nanjinhan/chamgap/docs/design/wireframe/png/09.png

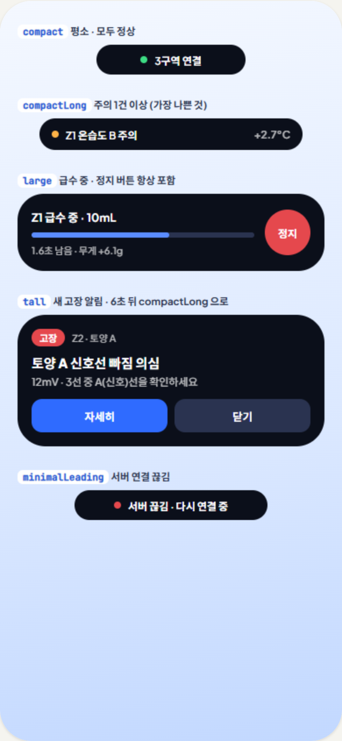
docs/design/wireframe/png/09.png
