nanjinhan/chamgap/docs/design/wireframe/png/08.png

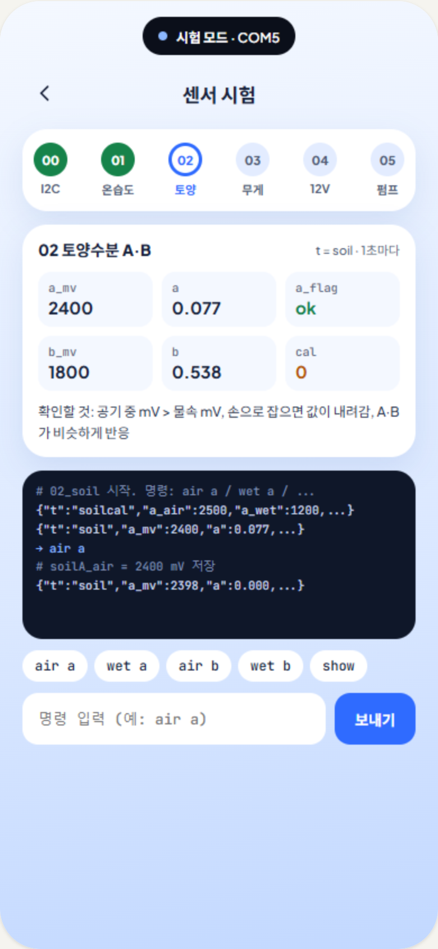
docs/design/wireframe/png/08.png
