nanjinhan/chamgap/docs/design/README.md

팀 디자인 시안은 `reference.png`, 와이어프레임 캡처는 `wireframe/` 폴더에 넣어 주세요. 웹앱을 만들 때 참고합니다.
