nanjinhan/chamgap/docs/01_requirements.md

# 참값(CHAMGAP) 센서 진단 시스템 — 요구사항지시서

| 항목 | 내용 |
|---|---|
| 문서 버전 | **v2.0 (2026-10-23)** — v1.0은 `docs/archive/01_requirements_v1.0.md` |
| 대상 | ESP32 펌웨어, Supabase(클라우드 DB), 웹앱, (선택) 진단 서버 |
| 기준 설계 | 3구역 시험장 제작 설계도 v0.8.1 (배선·핀 번호) |
| 이 문서의 역할 | 프로그램들이 서로 주고받는 **약속**의 기준. 코드와 이 문서가 다르면 이 문서를 먼저 고친 뒤 코드를 고친다 |

요구사항 번호 규칙: `SYS` 전체, `FW` ESP32 펌웨어, `COM` 통신 규약, `CLD` Supabase, `SRV` 진단 서버, `DX` 진단, `SAFE` 안전, `UI` 웹앱, `NFR` 비기능. 각 항목의 **필수/권장/선택**을 지킨다.

## 변경 이력

| 버전 | 바뀐 것 |
|---|---|
| v1.0 | ESP32 ─USB·로컬 MQTT─▶ 노트북 브리지 서버 ─▶ 웹앱. 같은 WiFi 안에서만, 인터넷 공개·로그인 제외 |
| **v2.0** | **ESP32 ─WiFi─▶ Supabase(무료) ◀─▶ 웹앱(Vercel)**. 인터넷 어디서나 접속, 로그인 없음. 급수 안전 검사를 ESP32로 옮김. 저장은 Supabase. 진단은 **선택 기능**(노트북 진단 서버가 켜져 있을 때). 웹 시험 모드 제외. 메시지 키·명령 문법은 v1.0과 같음 |

---

## 1. 목적과 범위

### 1.1 목적
1. **먼저**: 구역 3개(Z1·Z2·Z3)의 진짜 센서 값이 인터넷 어디서나 웹앱에 실시간으로 보이고, 웹앱에서 누른 명령(급수·정지·보정)을 ESP32가 실행해 결과가 웹에 돌아온다.
2. **다음(선택)**: 값을 보여 주는 데서 끝나지 않고, **"지금 이 값을 믿어도 되는지, 안 된다면 무엇이 문제이고 무엇을 확인해야 하는지"**를 알려 준다 (6장 진단).

### 1.2 범위
| 포함 | 선택 | 제외 |
|---|---|---|
| 센서 값 수집·표시·기록 (Supabase) | 센서 이상 진단과 확인 방법 안내 (진단 서버) | 자동 급수 스케줄 |
| 수동 급수(양 지정)와 즉시 정지 | 센서 시험 스케치 00~05 | 로그인 |
| 보정 작업 안내 (영점, 무게, 토양, 유량) | | 휴대폰 설치형 앱 |
| 인터넷 어디서나 접속 (웹앱: Vercel) | | 식물 생육 판단 |
| 하드웨어 없이 개발·시연하는 가짜 ESP32 | | 웹의 시험 모드 화면 (시험 스케치는 아두이노 IDE 시리얼 모니터로 본다) |

### 1.3 구역 하나의 구성 (설계도 기준, v1.0과 같음)
| 부품 | 수량 | ESP32 핀 | 비고 |
|---|---|---|---|
| SHT31 온습도 A (대상) | 1 | I2C SDA 21, SCL 22, 주소 0x44 | |
| SHT31 온습도 B (비교) | 1 | 같은 버스, 주소 0x45 | ADR→VIN |
| SEN0193 토양수분 A (대상) | 1 | GPIO32 (ADC1) | |
| SEN0193 토양수분 B (비교) | 1 | GPIO33 (ADC1) | |
| 로드셀 10kg + HX711 | 1 | DT 26, SCK 27 | 화분 전체 무게 |
| 연동 펌프 + DFR0457 | 1 | GPIO25 (+10kΩ 풀다운) | 12V |
| 12V 감지 분압 47k/10k | 1 | GPIO34 | 비상정지·퓨즈 감지 |
| 누수 감지 (선택) | 0~1 | GPIO35 (+풀업) | |

ADC2 핀은 WiFi와 함께 쓸 수 없으므로 아날로그 입력은 ADC1(GPIO32~39)만 쓴다 (위 배선이 이미 그렇다).

---

## 2. 시스템 구성

```
 [ESP32 Z1] ─┐                         ┌──────────── Supabase (무료) ────────────┐
 [ESP32 Z2] ─┼──WiFi · HTTPS/WSS──────▶│ readings · events · nodes · commands    │
 [ESP32 Z3] ─┘  값·사건 올림            │ (선택) diagnostics                       │
                명령 받아 실행 ◀────────│ Postgres + Realtime                      │
       │                               └──────────────▲──────────────────────────┘
       └─ USB 시리얼 (디버그용, 선택)                    │ 실시간 구독 · 명령 넣기
                                                       │
                                  [웹앱 (React, Vercel)] ◀── 폰·노트북 어디서나
                                                       │
                     (선택) [진단 서버 (Python, 노트북)] ── 값을 읽어 진단을 기록
```

| ID | 요구사항 | 구분 |
|---|---|---|
| SYS-01 | ESP32와 웹앱은 **Supabase 표를 통해서만** 주고받는다. 서로 직접 연결하지 않는다 | 필수 |
| SYS-02 | 펌프를 켜도 되는지의 **최종 판단은 ESP32**가 한다. 급수 안전 검사(7장 SAFE-03)는 ESP32가 하고, 웹은 요청과 사전 안내만 한다 | 필수 |
| SYS-03 | 메시지 내용(키 이름·명령 문법)은 v1.0 4장과 같다. Supabase 표의 열 이름은 메시지 키 이름과 같다. ESP32는 USB 시리얼에도 같은 줄을 계속 출력한다 | 필수 |
| SYS-04 | 하드웨어 없이 개발할 수 있도록 **가짜 ESP32**(기존 서버의 mock 재사용)가 실제 펌웨어와 똑같이 Supabase에 쓰고 명령에 응답한다. 고장 상황을 골라 재현할 수 있다 | 필수 |
| SYS-05 | **무료 등급**(Supabase Free, Vercel Hobby) 안에서 동작한다. 로그인은 없다 | 필수 |
| SYS-06 | 진단은 **진단 서버가 켜져 있을 때만** 붙는다. 웹앱은 진단을 만들지 않고 진단 서버가 준 결과만 보여 준다. 진단 서버가 꺼져 있어도 값 보기·명령은 동작한다 | 선택 |

---

## 3. ESP32 펌웨어 요구사항

| ID | 요구사항 | 구분 |
|---|---|---|
| FW-01 | 부팅 직후 가장 먼저 펌프 핀(GPIO25)을 LOW로 둔다 | 필수 |
| FW-02 | `sample_ms`(기본 5000ms, 범위 2000~600000)마다 측정값 1개를 Supabase `readings`에 넣고 시리얼에도 `data` 줄로 출력한다 | 필수 |
| FW-03 | 센서 하나가 고장 나도 나머지 값은 계속 보낸다. 고장 값은 `null` | 필수 |
| FW-04 | 로드셀은 막히지 않게 읽고, 최근 약 1초(10개) 평균과 표준편차를 보낸다 | 필수 |
| FW-05 | 보정값(토양 공기/물, 로드셀 영점/배율, 펌프 유량, 구역 이름, 주기)과 **오늘 급수량**은 ESP32 내부(NVS)에 저장해 전원이 꺼져도 유지한다 | 필수 |
| FW-06 | 시험 스케치(00~05)를 만들면, 거기서 저장한 보정값을 노드 펌웨어가 그대로 읽는다 (NVS 이름공간 `chamgap`) | 선택 |
| FW-07 | 시리얼 통신 속도 115200bps, 줄 끝 `\n`. 시리얼로 받은 명령도 실행한다 (USB 디버그) | 필수 |
| FW-08 | 같은 펌웨어를 세 보드에 올리고, 구역 이름은 `id z2` 명령으로 저장한다 (기본값은 `config.h`) | 권장 |
| FW-09 | WiFi(2.4GHz)가 끊기면 스스로 다시 연결한다. 끊긴 동안에도 측정·안전 동작은 계속하고, 그동안의 값은 올리지 않고 버린다 | 필수 |
| FW-10 | 명령은 **Supabase Realtime(WebSocket)**으로 받는다. 놓친 명령에 대비해 30초마다 `pending` 명령을 한 번 조회한다. Realtime을 쓸 수 없으면 2초 간격 조회로 대신한다 (1초 조회는 무료 전송량 때문에 쓰지 않는다) | 필수 |
| FW-11 | 명령은 한 번에 하나씩 실행하고, 받은 즉시 `sent`, 끝나면 ack를 `result`에 넣고 `done`/`failed`로 바꾼다. `stop`은 다른 명령보다 먼저 처리한다 | 필수 |
| FW-12 | 시각은 NTP(한국 시간)로 맞춘다. "오늘"(하루 급수 한도)은 한국 날짜 기준이며, 시각을 모르는 동안은 부팅 후 누적으로 센다 | 필수 |
| FW-13 | WiFi 이름·비밀번호, Supabase 주소·키, 기기 키는 `secrets.h`에만 둔다. 저장소에는 `secrets.example.h`만 넣는다 | 필수 |
| FW-14 | HTTPS로 Supabase에 접속한다. 처음에는 인증서 확인 없이(`setInsecure`) 시작하고, 이후 루트 인증서 고정을 권장한다 | 필수 |

### 3.1 NVS 저장 키 (이름공간 `chamgap`)
| 키 | 형 | 내용 | 저장하는 곳 |
|---|---|---|---|
| `soilA_air`, `soilA_wet`, `soilB_air`, `soilB_wet` | int (mV) | 토양 보정 | 02_soil, 노드 `soilcal` |
| `lc_off` | long | 로드셀 영점 raw | 03_loadcell, 노드 `tare` |
| `lc_scale` | float | raw/g | 03_loadcell, 노드 `cal` |
| `pump_mlps` | float | 초당 mL | 05_pump, 노드 `flow` |
| `sample_ms` | ulong | 보내는 주기 | 노드 `interval` |
| `node_id` | string | 구역 이름 (Z1) | 노드 `id` |
| `day_key` | ulong | 오늘 날짜 YYYYMMDD | 노드 (급수할 때) |
| `day_ml` | float | 오늘 급수량 mL | 노드 (급수할 때) |

---

## 4. 통신 규약

### 4.1 공통 형식 (v1.0과 같음)
| ID | 요구사항 | 구분 |
|---|---|---|
| COM-01 | 메시지 하나 = JSON 객체 하나. 시리얼에서는 한 줄, `{`로 시작 | 필수 |
| COM-02 | 시리얼에서 `#`로 시작하는 줄은 사람용 메모 | 필수 |
| COM-04 | 명령은 공백으로 나눈 **텍스트 한 줄**. 대소문자 구분 없음 (시리얼은 끝에 `\n`) | 필수 |
| COM-05 | 모든 JSON 메시지에는 `t`(종류), `node`(구역), `ms`(ESP32 부팅 후 ms)가 있다 | 필수 |
| COM-06 | 값이 없거나 고장이면 키를 빼지 않고 `null`을 넣는다 | 필수 |
| COM-07 | 참/거짓은 `1`/`0`으로 보낸다 | 필수 |
| COM-08 | 시간 기준은 Supabase가 붙이는 `created_at`이다 (ESP32 `ms`는 부팅 후 시간) | 필수 |
| COM-09 | 받는 쪽은 모르는 키가 와도 오류를 내지 않는다. 표에 없는 키는 `extra`(jsonb)에 보관한다 | 필수 |

### 4.2 메시지 종류: ESP32 → (Supabase · 시리얼)

#### `data` — 주기 측정값 → `readings` 표
```json
{"t":"data","node":"Z1","ms":20111,"seq":4,
 "sht_a_ok":1,"temp_a":23.40,"rh_a":45.10,
 "sht_b_ok":1,"temp_b":23.60,"rh_b":44.80,
 "soil_a_mv":2400,"soil_a":0.077,"soil_b_mv":1800,"soil_b":0.538,
 "hx_ok":1,"weight_g":500.0,"weight_sd":0.10,
 "v12":12.00,"leak":null,"pump":1,"rssi":-55}
```
| 키 | 형 | 단위 | 뜻 | null 일 때 |
|---|---|---|---|---|
| `seq` | int | | 1부터 1씩 증가. 재부팅하면 1로 | — |
| `sht_a_ok` / `sht_b_ok` | 0/1 | | 이번 읽기 성공 | — |
| `temp_a` / `temp_b` | float | °C | 공기 온도 | 읽기 실패 |
| `rh_a` / `rh_b` | float | %RH | 공기 습도 | 읽기 실패 |
| `soil_a_mv` / `soil_b_mv` | int | mV | 토양 센서 원시 전압 | — |
| `soil_a` / `soil_b` | float | 0~1 | 0=공기, 1=물 (보정값 기준) | 선 빠짐·단락 의심, 보정값 이상 |
| `hx_ok` | 0/1 | | 최근 1초 안에 HX711 응답 | — |
| `weight_g` | float | g | 화분 전체 무게 (영점 기준) | HX711 응답 없음, 보정 전 |
| `weight_sd` | float | g | 최근 약 1초 흔들림 | 위와 같음 |
| `v12` | float | V | 분기 퓨즈 뒤 12V | 12V 감지 사용 안 함 |
| `leak` | 0/1 | | 누수 감지 | 누수 센서 없음 |
| `pump` | 0/1 | | 지금 펌프 켜짐 | — |
| `rssi` | int | dBm | WiFi 세기 | WiFi 연결 안 됨 |

#### `evt` — 사건 → `events` 표
| `ev` | 추가 키 | 언제 |
|---|---|---|
| `boot` | `fw`, `reset`(`esp_reset_reason()` 번호), `sht_a`, `sht_b` | 전원·재시작 직후 1번 |
| `pump_on` | `dur`(ms), `ml`(급수량, `water`가 아니면 null) | 펌프 켜짐 |
| `pump_off` | `reason`, `dur`, `ran`(실제 켜진 ms), `ml`(**실제 켜진 시간 기준** mL, 유량 보정 전이면 null) | 펌프 꺼짐 |
| `refused` | `reason`, `dur`, `ml` | 펌프 요청 거부 |

`reason` 값:
| 값 | 뜻 |
|---|---|
| `done` | 정해진 시간 끝 |
| `stop` | 정지 명령 |
| `no_12v` | 12V 없음 (비상정지 눌림·퓨즈·선 빠짐) |
| `leak` | 누수 감지 |
| `reboot` | 재시작 명령 |
| `already_on` | 이미 켜져 있음 (거부) |
| `bad_ms` | 시간 범위 밖 (50~15000ms) (거부) |
| `cooldown` | 꺼진 지 3초 안 됨 (거부) |
| `bad_ml` | 1회 급수량 범위 밖 (1~50mL) (거부) — v2.0 추가 |
| `daily_limit` | 오늘 급수 한도 초과 (300mL) (거부) — v2.0 추가 |
| `flow_uncal` | 유량 보정 전이라 mL 급수 불가 (거부) — v2.0 추가 |
| `scale_dead` | 무게 센서 응답 없음 (거부) — v2.0 추가 |

#### `ack` — 명령 응답 → `commands.result` (+ 시리얼)
```json
{"t":"ack","node":"Z1","ms":15111,"cmd":"cal","ok":1,"msg":""}
```
명령마다 **정확히 1개**를 보낸다 (`status`, `info`도 각각 data·info를 보낸 뒤 ack 1개). `ok=0`이면 `msg`에 이유(위 `reason` 값 또는 짧은 영문)가 있다. 결과 값이 있는 명령은 ack에 키를 더한다 (예: `flowcal`의 `before_g`, `after_g`, `delta_g`).

#### `info` — 설정·보정 상태 → `nodes.info` (+ `events`)
부팅 직후, WiFi 연결 직후, 보정·설정 명령이 성공한 뒤, `info` 명령을 받았을 때 보낸다.
```json
{"t":"info","node":"Z1","ms":200,"fw":"node-2.0","sample_ms":5000,
 "soil_a_cal":0,"soil_b_cal":0,"soil_a_air":2500,"soil_a_wet":1200,"soil_b_air":2500,"soil_b_wet":1200,
 "lc_cal":0,"lc_offset":0,"lc_scale":0.0000,"pump_mlps":0.000,
 "v12_sense":1,"leak_sensor":0,"day_ml":0.0,"day_limit_ml":300,"max_ml":50}
```
v2.0: 토양 보정 여부를 채널별(`soil_a_cal`, `soil_b_cal`)로 보내고, 오늘 급수량과 한도를 함께 보낸다.

### 4.3 명령: 웹 → `commands` 표 → ESP32 (시리얼로도 같은 문법)
| 명령 | 예 | 하는 일 | 응답 |
|---|---|---|---|
| `help` | | 명령 목록 | ack |
| `status` | | 즉시 `data` 1개 | data + ack |
| `info` | | 설정·보정 상태 | info + ack |
| `water <mL>` | `water 10` | 안전 검사(SAFE-03) 후 저장된 유량으로 환산해 켬 | evt + ack |
| `stop` | | 즉시 끔 | evt(켜져 있었으면) + ack |
| `tare` | | 빈 판 영점 (약 2초) | ack |
| `cal <g>` | `cal 500` | 아는 무게로 배율 보정 (tare 먼저) | ack |
| `soilcal <a\|b> <air\|wet>` | `soilcal a air` | 토양 보정값 저장 | ack |
| `flowcal <ms>` | `flowcal 10000` | **유량 측정용 펌프 실행**: 안정 무게 → ms 동안 펌프 → 최대 60초 안정 대기 → 무게 증가 (저장은 안 함) | evt + ack(`before_g`,`after_g`,`delta_g`) |
| `flow <ms> <g>` | `flow 10000 23.5` | 유량 저장 (ms 동안 받은 물 g) | ack |
| `interval <ms>` | `interval 10000` | 보내는 주기 (2000~600000) | ack |
| `id <이름>` | `id z2` | 구역 이름 저장 (재시작 후 적용) | ack |
| `reboot` | | 재시작 | ack |
| `pump <ms>` | `pump 2000` | 시험용 펌프. **시리얼에서만** 받는다 (웹에서는 `water`·`flowcal`만) | evt + ack |

| ID | 요구사항 | 구분 |
|---|---|---|
| COM-10 | 웹은 명령을 넣은 뒤 결과를 기다린다: 기본 10초, `tare`·`cal` 15초, `flowcal`은 ms + 70초. 넘으면 "응답이 없어요"로 보여 준다 | 필수 |
| COM-11 | `stop`은 대기 중인 다른 명령보다 먼저 실행한다. 같은 구역의 대기 중인 `water`·`flowcal`은 `expired`로 바꾼다 | 필수 |
| COM-12 | **만든 지 10초가 넘은 명령은 실행하지 않고 `expired`**로 바꾼다 (ESP32가 늦게 켜졌을 때 오래된 급수가 실행되는 사고 방지). `stop`은 예외로 언제나 실행한다 | 필수 |
| COM-13 | 웹이 넣을 수 있는 명령은 위 표에서 `pump`·`help`를 뺀 것뿐이다 (DB 제약으로 막는다) | 필수 |

### 4.4 Supabase 표
| 표 | 쓰는 쪽 | 읽는 쪽 | 열 (요지) |
|---|---|---|---|
| `readings` | ESP32 | 웹, 진단 서버 | `id`, `created_at`, `node`, `ms`, 4.2 `data`의 키 전부, `extra jsonb` |
| `events` | ESP32, 웹(메모만), 진단 서버 | 웹, 진단 서버 | `id`, `created_at`, `node`, `t`(`evt`·`info`·`mark`·`diag_on`·`diag_off`·`water_result`), `ev`, `payload jsonb` |
| `nodes` | ESP32 | 웹, 진단 서버 | `node`(기본 키), `updated_at`, `last_seen`, `fw`, `info jsonb`, `pump`(0/1), `day_ml` |
| `commands` | 웹(넣기), ESP32(상태 바꾸기) | 웹, ESP32 | `id`, `created_at`, `node`, `cmd`, `status`(`pending`→`sent`→`done`/`failed`/`expired`), `picked_at`, `done_at`, `result jsonb` |
| `diagnostics` | 진단 서버 | 웹 | (선택) 6.2 형식 그대로, 구역·코드·센서별 1행. 지금 활성인 것만 |
| `service_status` | 진단 서버 | 웹 | (선택) `name`, `updated_at` — 진단 서버가 켜져 있는지 |

- 웹은 Realtime으로 `readings`·`events` 새 행, `commands`·`nodes`·`diagnostics` 변경을 구독한다.
- 구역 온라인 여부는 웹이 정한다: 마지막 `readings`가 `3 × sample_ms`(최소 15초)보다 오래되면 오프라인. 기기 시계 차이는 받은 행의 `created_at`으로 보정한다 (UI-11).

---

## 5. Supabase 요구사항

| ID | 요구사항 | 구분 |
|---|---|---|
| CLD-01 | Supabase **Free** 프로젝트 하나. 표·권한·함수는 `supabase/schema.sql` 한 파일로 만들고, 다시 실행해도 안전하다 | 필수 |
| CLD-02 | 권한(RLS): 누구나(anon) 모든 표를 **읽을 수 있다**. anon은 `commands`에 허용 명령만 **넣을 수 있고**, `events`에는 `t='mark'`만 넣을 수 있다. `readings`·`events`(나머지)·`nodes`·`commands` 상태 변경은 **기기 키**(요청 헤더 `x-device-key`)가 맞을 때만 된다. `diagnostics`·`service_status`는 진단 서버 키가 맞을 때만 쓸 수 있다 | 필수 |
| CLD-03 | 키: 웹에는 anon(public) key만 넣는다. 기기 키는 ESP32 `secrets.h`와 Supabase에만 둔다. **service_role key는 웹·펌웨어 어디에도 넣지 않는다** | 필수 |
| CLD-04 | 보관 기간: 14일 지난 `readings`, 30일 지난 `events`, 7일 지난 `commands`를 매일 지운다 (`pg_cron`) | 필수 |
| CLD-05 | 그래프용 함수 `history(node, minutes, bucket_s, metrics)`: `bucket_s`초 평균, null은 평균에서 뺀다 (1시간/6시간/24시간 → 60/300/900초) | 필수 |
| CLD-06 | CSV 내보내기는 웹이 `readings`를 받아 만든다 (엑셀용 BOM, 한글 머리글) | 권장 |
| CLD-07 | 무료 등급 한도 확인: DB 용량, 전송량(egress), Realtime 메시지 수, 오래 안 쓰면 일시정지. 5초 × 3구역 ≈ 하루 5만 행이므로 CLD-04 보관 기간으로 용량을 지킨다. 한도에 가까우면 `sample_ms`를 10초로 늘린다 | 필수 |

---

## 5A. 진단 서버 요구사항 (선택)

기존 Python 브리지 서버(`server/`)를 재사용한다. v1.0의 서버 요구사항(SRV-01~11)은 진단 서버로 쓸 때 해당하는 부분만 따른다.

| ID | 요구사항 | 구분 |
|---|---|---|
| SRV-D1 | Supabase의 `readings`·`events`·`nodes`를 Realtime으로 받아(또는 조회해) 6장 진단을 그대로 돌린다 | 선택 |
| SRV-D2 | 지금 활성인 진단을 `diagnostics` 표에 반영하고(생기면 넣고 사라지면 지움), 생김·사라짐을 `events`(`diag_on`·`diag_off`)에 남긴다. 급수 결과 판정은 `events`(`water_result`)에 남긴다 | 선택 |
| SRV-D3 | 30초마다 `service_status`를 갱신한다. 웹은 2분 넘게 갱신이 없으면 "진단 서버 꺼짐"으로 보여 준다 | 선택 |
| SRV-D4 | 진단 서버는 명령을 보내지 않는다 | 선택 |
| SRV-D5 | 가짜 ESP32(SYS-04)도 이 서버의 mock을 재사용한다 | 필수 |

---

## 6. 진단 요구사항 (진단 서버가 켜져 있을 때)

v1.0 6장과 같다. 진단 서버가 꺼져 있으면 웹은 진단 목록 대신 "진단 서버가 꺼져 있어요 (값 보기·급수는 됩니다)"를 보여 준다.

### 6.1 원칙
| ID | 요구사항 | 구분 |
|---|---|---|
| DX-01 | 진단마다 **무엇이 / 왜 의심되는지 / 무엇을 확인할지**를 한국어로 준다 | 필수 |
| DX-02 | 순간 튐으로 경고가 깜빡이지 않게, 규칙마다 **유지 시간**을 둔다. 해제는 정상 상태가 유지 시간만큼 이어진 뒤에 한다 | 필수 |
| DX-03 | 기준값은 `diagnostics.yaml` 한 파일에 두어 코드 수정 없이 바꾼다 | 필수 |
| DX-04 | 진단이 생기거나 사라질 때 `events`에 기록한다 | 필수 |
| DX-05 | 보정 전이라 생기는 문제는 `fault`가 아니라 `info`로 보여 주고, 해당 보정 화면으로 가는 버튼을 준다 | 필수 |
| DX-06 | 한 원인이 여러 증상을 만들면 **원인 하나만** 크게 보여 준다. 예: 구역이 오프라인이면 그 구역의 센서별 진단은 숨긴다. 12V가 없으면 "급수 안 됨" 진단은 숨긴다 | 필수 |

### 6.2 진단 형식
```json
{
  "code": "SHT_AB_DIFF",
  "node": "Z1",
  "sensor": "sht_b",
  "severity": "warn",
  "title": "온습도 A·B 차이가 큼",
  "detail": "B가 A보다 2.7°C 높음 (10분째)",
  "causes": ["B 센서 근처에 열원(전장함·조명)이 있음", "B 센서 고장", "A·B 높이가 다름"],
  "checks": ["A·B를 손으로 바꿔 끼워 보고 차이가 따라가는지 본다", "거치대 높이를 확인한다"],
  "since": "2026-10-23T16:40:00+09:00",
  "action": {"label": "센서 상세 보기", "to": "/zone/Z1/sensor/sht_b"}
}
```

### 6.3 진단 규칙 목록 (기준값은 시작값. 시험하며 조정)
| 코드 | 센서 | 조건 | 유지 | 단계 | 확인 방법 (요지) |
|---|---|---|---|---|---|
| `NODE_OFFLINE` | 구역 | 마지막 data 후 `3 × sample_ms` 이상 지남 (최소 15초) | — | offline | 전원, WiFi, ESP32 LED |
| `NODE_REBOOTED` | 구역 | `boot` 사건 또는 seq가 줄어듦 | 표시 5분 | info | 전원 불안정? 펌프 켤 때 재시작이면 전원 분리 확인 |
| `MSG_GAP` | 구역 | seq가 건너뜀 (10분 안 3회 이상) | — | warn | WiFi 세기(rssi < -75) |
| `SHT_NO_RESP` | sht_a/b | `sht_*_ok = 0` | 15초 | fault | 4심 케이블, 주소(ADR), I2C 길이 |
| `SHT_RANGE` | sht_a/b | 온도 -10~60 밖 또는 습도 0~100 밖 | 즉시 | fault | 센서 손상, 물 묻음 |
| `SHT_AB_DIFF` | sht_b | \|ΔT\| > 1.0°C 또는 \|ΔRH\| > 5% | 10분 | warn | 위치·열원, A·B 바꿔 끼우기 |
| `SHT_STUCK` | sht_a/b | 30분 동안 값 변화 0.02 이하 | 30분 | warn | 센서 멈춤, 재시작 |
| `SOIL_WIRE` | soil_a/b | mV < 150 또는 > 3050 | 15초 | fault | 신호선 빠짐(낮음) / GND 빠짐·단락(높음) |
| `SOIL_UNCAL` | soil_a/b | info의 `soil_a_cal`/`soil_b_cal = 0` | — | info | 토양 보정 마법사로 |
| `SOIL_AB_DIFF` | soil_b | \|A − B\| > 0.25 | 10분 | warn | 꽂은 깊이, 흙 다짐, 물 떨어지는 위치 |
| `SOIL_NO_RISE` | soil_a/b | 급수 후 15분 안에 무게는 늘었는데(+예상량 50% 이상) 수분은 0.02 이하로 오름 | — | warn | 센서 깊이·흙 접촉, 물이 한쪽으로만 흐름 |
| `SOIL_STUCK` | soil_a/b | 6시간 동안 변화 10mV 이하 | 6시간 | info | 너무 마르거나 젖음, 센서 확인 |
| `LC_NO_RESP` | scale | `hx_ok = 0` | 15초 | fault | HX711 배선(DT/SCK), 3.3V 전원 |
| `LC_UNCAL` | scale | `lc_cal = 0` 또는 weight_g null이고 hx_ok=1 | — | info | 로드셀 보정 마법사로 |
| `LC_NOISY` | scale | `weight_sd` > 5g | 2분 | warn | 케이블이 판을 당김, 판이 닿음, 바람·진동 |
| `LC_NEGATIVE` | scale | weight_g < −50 | 1분 | warn | 화분 올린 채 영점 잡음, 판 닿음 |
| `LC_OVERLOAD` | scale | weight_g > 7000 | 즉시 | fault | 정격 초과 (10kg 센서, 7kg 이하 운용) |
| `LC_DRIFT_UP` | scale | 급수·메모 없이 1시간에 +20g 이상 | 1시간 | warn | 무언가 판에 기댐, 온도 드리프트 |
| `WATER_NOT_ARRIVED` | pump | `pump_off(done)` 후 2분 안에 무게 증가 < 예상 mL의 50% | — | fault | 튜브 막힘·꺾임, 펌프 헤드, 출수구가 화분 밖 |
| `WATER_OVER` | pump | 무게 증가 > 예상 mL의 150% | — | warn | 유량 보정 다시, 사이펀 |
| `PUMP_REFUSED` | pump | `refused` 사건 | 표시 2분 | warn | reason별 안내 |
| `FLOW_UNCAL` | pump | `pump_mlps = 0` | — | info | 유량 보정 마법사로 |
| `V12_MISSING` | power | v12 < 9.0 | 3초 | warn | 비상정지 눌림, 분기 퓨즈, 어댑터 |
| `LEAK` | power | leak = 1 | 즉시 | fault | 받침 위 물기 제거, 튜브 연결부 |

`WATER_*` 판정은 무게 흔들림(`weight_sd`)이 3g 이하로 안정된 값끼리 비교한다. 물 1mL = 1g으로 본다.

### 6.4 가짜 ESP32 고장 시나리오 (개발·시연용)
`normal`, `offline`, `sht_b_dead`, `sht_b_hot`(B가 +3°C), `soil_a_unplugged`, `soil_ab_diff`, `lc_dead`, `lc_noisy`, `estop_pressed`, `water_clog`(급수해도 무게 안 늘어남), `leak`. 진단 서버가 켜져 있으면 시나리오를 켰을 때 6.3절의 해당 진단이 실제로 떠야 한다 (**검수 기준**).

---

## 7. 안전 요구사항

| ID | 요구사항 | 구분 |
|---|---|---|
| SAFE-01 | ESP32는 부팅 시 펌프 OFF, 한 번 최대 15초, 끝나면 스스로 끔. **WiFi·Supabase가 끊겨도** 정해진 시간 뒤 꺼진다 | 필수 |
| SAFE-02 | ESP32는 12V가 없거나 누수면 펌프 요청을 거부하고, 켜져 있으면 즉시 끈다 | 필수 |
| SAFE-03 | **ESP32**가 `water`를 실행하기 전에 차례로 검사하고, 실패하면 `refused`와 이유를 남긴다: 펌프 꺼짐(`already_on`) → 꺼진 지 3초(`cooldown`) → 1회 1~50mL(`bad_ml`) → 오늘 합계 + mL ≤ 300(`daily_limit`) → 유량 보정됨(`flow_uncal`) → 12V 있음(`no_12v`) → 누수 없음(`leak`) → 무게 센서 응답(`scale_dead`) | 필수 |
| SAFE-04 | 웹은 같은 검사를 마지막 값으로 미리 계산해 "켜기 전 점검"으로 **보여 주기만** 한다. 실패 항목이 있으면 급수 버튼을 막고 이유를 보여 준다. 유량 보정 전이면 보정 화면으로 안내한다 | 필수 |
| SAFE-05 | 웹앱의 급수 버튼은 **길게 눌러 확인**(1초)해야 실행된다 | 필수 |
| SAFE-06 | 웹앱 어느 화면에서든 **모두 정지** 버튼이 한 번에 닿는다. 정지는 확인 없이 즉시 (모든 구역에 `stop` 명령) | 필수 |
| SAFE-07 | 비상정지 스위치(하드웨어)가 소프트웨어보다 항상 우선이다. 웹앱은 이를 대신하지 않음을 화면에 표시한다 | 필수 |
| SAFE-08 | 로그인이 없으므로 **웹 주소를 아는 사람은 누구나 명령을 보낼 수 있다.** 주소는 팀 안에서만 공유한다. 피해는 SAFE-01~03(15초, 50mL, 하루 300mL)과 COM-13(허용 명령)으로 제한한다 | 필수 |
| SAFE-09 | 만든 지 10초가 넘은 명령은 실행하지 않는다 (COM-12) | 필수 |
| SAFE-10 | 하루 급수량은 ESP32 NVS에 저장해 재시작해도 초기화되지 않는다 | 필수 |

---

## 8. 웹앱 요구사항 (화면은 와이어프레임·`docs/03_PROMPT_webapp.md` 참고)

| ID | 요구사항 | 구분 |
|---|---|---|
| UI-01 | 화면: 홈(전체), 구역 상세, 센서 상세, 급수, 진단 목록, 보정 마법사, 기록/그래프, 설정. (v1.0의 시험 모드는 제외) | 필수 |
| UI-02 | 디자인은 팀 시안(연하늘 그라데이션 배경, 흰 둥근 카드, 파란 포인트, 알약 탭, 원형 게이지, 원형 아이콘 버튼, 슬라이더)을 따른다 | 필수 |
| UI-03 | 맨 위 **Dynamic Island**(cult-ui)가 실시간 상태를 보여 준다: 평소 연결 상태 → 경고 발생 시 펼쳐짐 → 급수 중 진행 표시 | 필수 |
| UI-04 | React Bits 컴포넌트를 활용해 움직임을 준다. 단, 숫자·경고의 **가독성을 해치면 안 된다** | 필수 |
| UI-05 | 상태 색: ok 초록, info 파랑, warn 주황, fault 빨강, offline 회색. 색만으로 구분하지 않고 글자·아이콘도 함께 쓴다 | 필수 |
| UI-06 | 모바일(390px)에서 먼저 설계하고, 노트북(1280px 이상)에서는 2~3단으로 넓힌다 | 필수 |
| UI-07 | Supabase 실시간 연결이 끊기면 화면 위에 표시하고, 마지막 값에 "몇 초 전" 표시를 한다. 자동으로 다시 연결한다 | 필수 |
| UI-08 | 값 옆에 "언제 값인지"(n초 전)를 표시한다. 30초가 넘으면 흐리게 한다 | 필수 |
| UI-09 | 움직임 줄이기 설정(`prefers-reduced-motion` 또는 앱 설정)이면 배경·텍스트 애니메이션을 끈다 | 필수 |
| UI-10 | 모든 문구는 한국어. 센서 이름은 "온습도 A(대상)"처럼 역할을 같이 쓴다 | 필수 |
| UI-11 | 구역 온라인 여부와 "n초 전"은 웹이 `created_at`으로 계산한다 (기기 시계 차이 보정). 이것은 진단이 아니라 연결 표시다 | 필수 |
| UI-12 | Supabase 주소·anon key는 환경변수(`VITE_SUPABASE_URL`, `VITE_SUPABASE_ANON_KEY`)로 받는다. 코드에 쓰지 않는다 | 필수 |
| UI-13 | 진단 서버가 꺼져 있으면 진단 자리에 그 사실을 알리고, 값·급수·보정은 그대로 쓸 수 있게 한다 | 필수 |

---

## 9. 비기능 요구사항

| ID | 요구사항 | 구분 |
|---|---|---|
| NFR-01 | 측정 → 웹앱 표시까지 3초 안 | 필수 |
| NFR-02 | 웹에서 명령 → ESP32 실행 시작까지 3초 안 (Realtime). 대체 조회 방식이면 5초 안 | 필수 |
| NFR-03 | 웹앱을 8시간 이상 켜 두어도 메모리가 계속 늘지 않는다 (목록 길이 제한) | 필수 |
| NFR-04 | ESP32는 며칠 동안 재시작 없이 동작하고, WiFi·Supabase가 끊겼다 돌아오면 스스로 다시 연결한다 | 필수 |
| NFR-05 | 무료 등급 한도 안에서 3구역 상시 운용 (CLD-07) | 필수 |
| NFR-06 | 웹앱 첫 화면 표시 3초 안 (폰 LTE 기준 권장), 무거운 WebGL 배경은 1개만 | 권장 |
| NFR-07 | 펌웨어는 Arduino IDE 2와 `arduino-cli`로 컴파일된다. 필요한 라이브러리와 버전을 README에 적는다 | 필수 |
| NFR-08 | 진단 규칙마다 가짜 데이터로 자동 시험(pytest)이 있다 (진단 서버, 기존 220개 유지) | 필수 |

---

## 10. 단계별 진행과 검수

| 단계 | 내용 | 끝났다고 보는 기준 |
|---|---|---|
| P0 | 이 문서 v2.0 | 사용자 확인 |
| P1 | Supabase 준비 (`supabase/schema.sql`) | 사용자 프로젝트에 표가 생기고, anon key로 읽기·명령 넣기는 되고 기기 키 없이 `readings` 쓰기는 거부됨 |
| P2 | ESP32 노드 펌웨어 | 컴파일 통과. 실물이 있으면 Z1 값이 Supabase `readings`에 5초마다, 명령의 `status`가 `done`으로 바뀜 |
| P3 | 가짜 ESP32 → Supabase | 하드웨어 없이 3구역 값이 Supabase에 들어가고, 명령에 펌웨어와 같은 ack가 돌아옴. 고장 시나리오 재현 |
| P4 | 웹 데이터 계층 Supabase로 교체 | 웹에서 3구역 값이 실시간으로 바뀌고, 명령 결과가 돌아옴. 연결을 끊었다 붙이면 다시 연결됨 |
| P5 | 웹 화면 | 와이어프레임 화면 전부. 급수 → 섬 진행 표시 → 결과, 보정 마법사가 ack 기반으로 진행 |
| P6 | (선택) 진단 서버 | 6.4 시나리오마다 해당 진단이 웹에 뜸 |
| P7 | Vercel 배포 + 실물 | 폰 LTE로 웹 주소 접속. Z1 하나로 급수 → 무게 증가 → 수분 상승까지 화면에서 확인, 이어서 3구역 |

---

## 11. 미정 사항
| 항목 | 정할 사람 | 기한 |
|---|---|---|
| 진단 기준값 (6.3절) 실제 조정 | 팀 | P6·P7 |
| 누수 센서 사용 여부 → `USE_LEAK` | 팀 | P2 전 |
| 12V 감지 분압 사용 여부 → `USE_V12_SENSE` | 팀 | P2 전 |
| 하루 급수 한도 300mL·1회 50mL 적정성 | 팀 | P7 |
| 진단 서버(P6)를 할지 | 팀 | P5 끝난 뒤 |
| 시험 스케치 00~05를 만들지 | 팀 | P2 |
| Supabase 무료 등급 최신 한도(용량·전송량·Realtime·일시정지) 확인 | 개발 | P1 |
| 웹 주소 보호를 더 할지 (로그인 없이 쓰는 위험, SAFE-08) | 팀 | P7 |
