nanjinhan/chamgap/docs/04_이어서_만들기.md

# 참값(CHAMGAP) — 이어서 만들기 (작업 인계서)

| 항목 | 내용 |
|---|---|
| 마지막 갱신 | 2026-10-24 |
| 이 문서의 역할 | 다른 채팅방(새 AI 세션)에서 이 프로젝트를 **그대로 이어서** 만들 수 있게, 목표·결정·진행 상황·다음 할 일·규칙을 한곳에 모은 것 |
| 프로젝트 위치 | **`C:\dev\chamgap`** (2026-10-23 OneDrive 바탕화면에서 옮김: node_modules 동기화·비밀값 클라우드 업로드 문제). GitHub: https://github.com/nanjinhan/chamgap |
| 새 채팅에서 할 말 | "`docs/04_이어서_만들기.md`를 읽고, '4. 앞으로 할 일'의 다음 단계부터 이어서 해줘" |

> **지금 바로 할 일 (2026-11-03 밤 기준)** — 앱 화면 **전부** 새 디자인 톤으로 완료하고 **배포까지 반영함** (GitHub 푸시 → Vercel 자동 배포, https://chamgap.vercel.app 에서 새 디자인 확인)
> - **된 것**: ESP32(토양 A만) → Supabase → 웹(React) → Vercel 배포(https://chamgap.vercel.app). 사용자 새 디자인(`design/*.jpg` 9장)으로 9개 화면 + 넓은 화면(2단) + **보정 마법사·기록·진단·설정** 완료, **2026-11-03 19:36 푸시 → 1분 안에 배포 반영 확인**(폰 크기 첫 화면 2.1초, 하위 화면 6개 주소 바로 열림, 콘솔 오류 0) (3.9)
> - **급수 화면 (2026-11-03 밤)**: 급수 상태(08)·결과(09)를 펌프가 안 돌아도 **언제든** 들어가게 바꿈 — `/water/Z1/now`, `/water/Z1/result` (3.9 끝)
> - **다음 세션 첫 일**: ① (끝남: 배포 반영) ② 아래 열린 질문 2개 답 받기 ③ 보드를 다시 켜면 **토양 A 보정**(`/calibrate/Z1/soil`)부터 실제로 해 보기 (지금 토양값이 보정 전이라 −0.10) ④ 사용자 화면 피드백
> - **열린 질문**: (가) Z2·Z3 식물 이름(지금 Z2 Pothos·Z3 Sansevieria, `web/src/config/zones.ts`) (나) 보드가 쓰는 학교 WiFi가 휴대폰 핫스팟·휴대용 공유기인지 — 보드가 07:55 UTC 이후 다시 안 붙음(이유 200=공유기 신호 사라짐, 3.8·3.9)
> - 규칙: 디자인 세트를 받으면 **세트 전체를 한 단계로** 만들고 멈춘다(사용자: "왜 메인만 만들었어", "반응형이 아니라 폰 구조 하나만"). 그 밖에는 여전히 한 단계씩

---

## 0. 가장 중요한 작업 규칙 (사용자 요청)

1. **한 번에 한 단계만** 만든다. 끝나면 ① 무엇을 만들었는지 ② 어떻게 확인했는지 ③ 사용자가 직접 확인하는 방법을 짧게 소개하고 **멈춘다.** 사용자가 "다음/진행"이라고 해야 다음 단계로 간다.
   - 이전 세션에서 확인 없이 여러 단계를 이어서 만들어 사용자가 불만을 표시했다. 절대 반복하지 않는다.
2. 사용자는 **아두이노(ESP32) 코드까지 전부 AI가 만들어 주기**를 원한다. 사용자가 직접 코딩하지 않는다고 가정하고, 사용자가 해야 하는 일(Supabase 가입, 키 복사, 보드에 올리기)은 클릭 단위로 안내한다.
3. 모든 사용자용 문구는 한국어, 코드·변수 이름은 영어.
4. 끝나지 않은 일은 "끝났다"고 말하지 않는다. 확인 못 한 것(실물 하드웨어 등)은 확인 못 했다고 말한다.
5. 이 문서를 단계가 끝날 때마다 갱신한다 (특히 "3. 지금까지 한 것"과 "4. 앞으로 할 일"의 체크).

---

## 1. 목표 (사용자 말 기준)

> "아두이노 코드랑 이 웹앱이 잘 연결돼서, 진짜 센서값이 웹에 보이고, 웹에서 뭘 누르면 아두이노에서 실행되는 것"

- 구역 3개(Z1·Z2·Z3)의 ESP32가 센서값(온습도 A·B, 토양 A·B, 무게, 12V, 누수)을 보내고 웹앱이 실시간으로 보여 준다.
- 웹앱에서 급수(mL)·정지·보정 명령을 누르면 ESP32가 실행하고 결과가 웹에 돌아온다.
- **인터넷으로 어디서나** 접속한다. **Supabase 무료**를 쓴다 (사용자가 이전에 Supabase 무료로 아두이노 연결을 해 본 적이 있다).
- **로그인 없음** (팀이 하나만 쓰는 앱).

원래 목적(요구사항지시서 1.1): 값을 보여 주는 데서 끝나지 않고 "이 값을 믿어도 되는지, 아니면 무엇을 확인할지" 알려 주는 진단. → 새 구조에서 진단을 어디에 둘지는 **미정** (8장 질문 1).

---

## 2. 결정된 것 · 바뀐 것 (2026-10-23)

사용자가 "요구사항지시서를 바꾸면 된다"고 했다. 아래가 바뀐 방향이고, **`docs/01_requirements.md` v2.0에 반영했다** (P0, 사용자 확인 대기). v1.0은 `docs/archive/01_requirements_v1.0.md`.

| 항목 | 원래 지시서 v1.0 | 새 결정 |
|---|---|---|
| 연결 경로 | ESP32 ─USB 시리얼/로컬 MQTT─▶ 노트북 파이썬 서버 ─▶ 웹앱 | **ESP32 ─WiFi─▶ Supabase(무료) ◀─▶ 웹앱** |
| 웹앱 호스팅 | 노트북 서버가 띄움 (같은 WiFi에서만) | **Vercel(무료)** — 인터넷 어디서나 |
| 인터넷 공개·로그인 | 범위 밖 | 인터넷 공개 O, **로그인 없음** (주소는 팀 안에서만 공유) |
| 파이썬 브리지 서버 | 필수 (진단·안전 검사·저장 담당) | **필수 아님.** 진단 서버(P6, 선택)와 가짜 ESP32(P3)로 재사용 |
| 진단 | 필수 | **(가) 값 보기 + 명령을 먼저 끝까지** 만들고, (나) 진단은 P5 뒤에 할지 정한다 (사용자가 제안을 받아들임, 2026-10-23) |
| 웹 시험 모드 화면 | 있음 | **제외** (시험 스케치는 아두이노 IDE 시리얼 모니터로). v2.0에서 정함 — 사용자 확인 대기 |
| 명령 전달 | 서버 대기열 | ESP32가 Supabase Realtime으로 받고, 만든 지 10초 넘은 명령은 `expired` (안전) |
| 급수 전 안전 검사 (SAFE-03) | 서버가 검사 | **ESP32 펌웨어가 최종 검사** (15초 상한, 12V, 누수, 하루 한도, 유량 보정, 오래된 명령 무시) + 웹은 미리 안내만 |
| 저장 | 노트북 SQLite + JSONL | **Supabase Postgres** |

### 새 구조 그림
```
[ESP32 Z1~Z3] ──WiFi(HTTPS)──▶ [Supabase 무료: Postgres + Realtime]
   센서값·사건 올림                 readings / events / nodes / commands 표
   commands 표에서 명령 가져가 실행  ▲
                                   │ 실시간 구독 · 명령 넣기
                          [웹앱 (React, Vercel)]  ◀── 폰·노트북 어디서나
(선택) [파이썬 진단 서버, 노트북] ── Supabase 값을 읽어 진단을 diagnostics 표에 기록
```

---

## 3. 지금까지 한 것

### 3.1 브리지 서버 `server/` — 원래 계획(프롬프트 ①) S1~S9 **모두 완료**
- Python 3.12, FastAPI. 테스트 **220개 통과**, ruff 경고 0 (2026-10-23 확인).
- **실물 ESP32·Mosquitto로는 확인하지 못했다** (하드웨어 없음). 시리얼은 pyserial `loop://`, MQTT는 파이썬 브로커(amqtt)로 시험했다.

| 단계 | 내용 | 주요 파일 |
|---|---|---|
| S1 | 뼈대, 설정, 통신 규약 해석, 명령 문자열·허용 목록 | `config.py`, `protocol.py`, `clock.py` |
| S2 | 시리얼 링크(자동 탐색·2초 재연결), hub, 콘솔 요약, JSONL 기록 | `links/serial_link.py`, `hub.py`, `storage.py` |
| S3 | 구역별 명령 대기열(ack·시간 초과·stop 우선), 급수 전 8단계 안전 검사, 명령 API | `commands.py`, `safety.py`, `api.py` |
| S4 | **mock 링크: 가짜 ESP32 3대** (물리 흉내, 펌웨어와 같은 응답, 고장 시나리오 11개) | `links/mock_link.py` |
| S5 | **진단 엔진: 규칙 24개**, 유지·해제 시간, 억제(DX-06), 기준값 yaml, 급수 추적 | `diagnostics/*`, `tracking.py` |
| S6 | SQLite 저장, 이력·사건·CSV(엑셀 BOM) API, 재시작 복원 | `storage.py` |
| S7 | WebSocket 방송, `/api/state`(지시서 5.3 형식), 1초 타이머 | `ws.py` |
| S8 | MQTT 링크 (paho 2.x, 유언 메시지로 오프라인 즉시 감지) | `links/mqtt_link.py` |
| S9 | 빌드된 웹 서빙(SPA), LAN 주소 배너, PIN, CORS, README, `run_server.bat/.sh` | `netinfo.py`, `README.md` |

- 서버 README 맨 아래에 **펌웨어 확인이 필요한 5가지 TODO**가 있다 (status/info 응답 형식, pump_off의 ml 의미, soil_cal 채널, reset 번호, 유량 보정 전 water 응답). 새 펌웨어를 우리가 직접 만들므로 P2에서 우리가 정하면 된다.
- 새 구조에서의 쓸모: ① 진단 엔진(24규칙)을 진단 서버로 재사용(P6) ② mock ESP32를 하드웨어 없는 개발·시연용 가짜 데이터원으로 재사용(P3).

### 3.2 웹앱 `web/` — 원래 계획(프롬프트 ②) W1~W3 완료, W4~W12 남음
- Vite 8 + React 19 + TypeScript 6(strict) + Tailwind v4 + shadcn(radix-nova) + zustand + recharts + motion.
- `npm run lint`·`npx tsc -b`·`npm run build` 모두 통과 (2026-10-23).

| 단계 | 상태 | 내용 |
|---|---|---|
| W1 | 완료 | 뼈대: 디자인 토큰(`src/styles/tokens.css`), AppShell(배경·섬 자리·하단 탭 바·**모두 정지 버튼**), 빈 화면 10개 라우트, Vite 프록시, ESLint+Prettier |
| W2 | 완료 | **React Bits 35개 + cult-ui Dynamic Island 설치** (`src/components/react-bits/`, `src/components/ui/`), 래퍼 `src/components/fx/`, 움직임 줄이기, `/dev/fx` 데모(개발 모드만), `web/COMPONENTS.md` |
| W3 | 완료 (**바꿔야 함**) | 타입(`src/types/api.ts`), WebSocket(`src/lib/ws.ts`), REST(`src/lib/api.ts`), store(`src/store/useAppStore.ts`), `useNow`(서버 시계 기준 "n초 전"), 형식(`src/lib/format.ts`). **지금은 파이썬 서버의 `/api`·`/ws`에 붙어 있다 → P4에서 Supabase로 교체** |
| W4~W12 | 남음 | Dynamic Island, 홈, 진단 목록, 구역·센서 상세, 급수, 보정 마법사, 기록, 시험 모드, 설정, 노트북 대시보드, 배포 |

W2에서 알아 둘 것 (자세한 표는 `web/COMPONENTS.md`):
- `src/components/ui/dynamic-island.tsx` **원본 1줄 수정** (`// MODIFIED:` 표시, TS type import). 원본 setSize는 직전 크기로 못 돌아가므로 크기 전환은 `scheduleAnimation`을 쓴다.
- PulseHeart(클릭 때만 뛰는 좋아요 버튼) → `PulseDot`로 대체. AnimatedList(선택형 listbox) → 진단·점검 목록은 `FxList`(motion layout)로 대체, 기록 화면 사건 목록에만 사용.
- BorderGlow는 마우스 근처에서만 빛나서 주황 테두리를 항상 깐다. ElectricBorder는 화면당 1개.
- HoldButton(1초 길게 누르기)은 Space·Enter 길게, Esc 취소를 원본이 지원.
- **와이어프레임**(사용자 제공): `docs/design/wireframe/` — `png/01~10.png` 캡처, `src/NN.src.html` 원본 HTML. **화면은 반드시 여기 인라인 스타일(색·크기·간격)을 그대로 따른다.** (사용자가 처음 만든 화면을 보고 "와이어프레임대로 안 했다, 쓸데없는 효과만 넣었다"고 불만을 표시했다)
- **디자인 바로잡기 1단계 완료 (2026-10-23)**: 공통 틀(검은 알약 섬, 아이콘 알약 하단 메뉴 + 빨간 정지 버튼, 단순 그라데이션 배경, 하위 화면 헤더)과 **홈(와이어프레임 01)**을 와이어프레임대로 다시 만듦. 글꼴을 와이어프레임과 같은 Plus Jakarta Sans + Noto Sans KR로 바꿈. 앱에서 오로라 배경·클릭 반짝임·Dock을 뺌(설치 파일은 남아 있음). 아이콘은 와이어프레임 SVG를 그대로 옮긴 `src/components/icons.tsx`. 정지 버튼 동작(모든 구역 정지 + 알림)까지 연결. 확인: 390×844에서 와이어프레임 01과 위치·색 일치, 캐러셀을 넘기면 아래 센서 목록이 그 구역으로 바뀜.

### 3.3 펌웨어 `firmware/node/` — USB 시리얼 버전 (2026-10-23) → P2에서 WiFi 버전으로 (3.6)
- 사용자가 (2026-10-23 당시) 단 센서: **DHT11 1개(온습도 A 자리, SHT31 납땜 전 임시)** — 2026-10-24 SHT31 A·B로 바뀜(3.6), **토양 2개**, **로드셀+HX711(DT26·SCK27)**. 사용자가 준 로드셀 시험 코드는 bogde HX711 라이브러리.
- `node.ino` + `config.h`(센서 켜고 끄기·핀). 규약은 지시서 4장 그대로, 시리얼 JSON + 명령(info·status·tare·cal·soilcal·flow·interval·id·reboot·pump·water·stop). 펌프 안전(15초·쿨다운·50/300mL·12V·누수·scale_dead) 포함. `flowcal`은 아직(P2).
- 규약 밖 추가: data `weight_raw`(보정 전 원시값), info `sensor_a`·`*_present`(미설치 센서 구분). 웹 홈이 "미설치"·"raw … · 보정 전"으로 보여 준다.
- 이 노트북 arduino-cli로 **컴파일 통과**. 같은 형식의 가짜 줄(socket://)로 서버·웹 표시 확인. **사용자 말(2026-10-23): 실물 보드에 올려 USB로 연결·센서값까지 됐다** (AI는 직접 보지 못함). WiFi는 아직 안 씀 → P2에서 처음 확인. (DHT11은 2026-10-24에 SHT31 A·B로 바뀌어 DHT_PIN 확인은 필요 없어짐)
- 서버: mock 모드 기록은 `data/mock/`·`logs/mock/`에 따로 저장하도록 바꿈 (실제 기록과 섞이지 않게).

### 3.4 기타
- 폴더 정리: 문서는 `docs/`, 펌웨어는 `firmware/node/`.
- 메모리 장기 시험(서버): 15분 실측 RSS 61.1→62.4MB (이력 링버퍼가 차는 동안 증가, 상한 있음). 8시간 실측은 안 함.

### 3.5 Supabase `supabase/` — P1 완료 (2026-10-23)
- 조직 `chamgap`(Free), 지역 **도쿄**(ap-northeast-1, 서울에 장애가 있어 도쿄로 잡힘 — 그대로 쓰기로 함). **Project URL: `https://luikttaomstcdvbdcmhk.supabase.co`**. 공개 키(`sb_publishable_…`)는 `web/.env.local`·`firmware/node/secrets.h`에 있다 (둘 다 git 제외. 공개 값이라 Vercel 환경변수에도 이것을 넣는다)
- `schema.sql`을 SQL Editor에서 실행 성공 ("Run and enable RLS" 선택 → `private.secrets`에도 RLS 켜짐, 동작에 문제 없음). 첫 실행은 `commands` CHECK의 정규식을 `||`로 이어 붙여 `~`와 우선순위가 섞여 실패 → 한 문자열로 고침
- `device_key`·`diag_key`는 **사용자 메모장에만** 있다 (채팅·GitHub 금지). device_key → ESP32 `secrets.h`, diag_key → 진단 서버(선택). DB 비밀번호·secret(service_role) 키는 받지 않는다 — 웹·ESP32 어디에도 필요 없다
- 권한 확인 **`node supabase/check.mjs`** (`web/.env.local`의 공개 키 사용) — 2026-10-23 **23개 모두 통과**: 읽기 O(표 6개·`latest_readings`·`history()`) / `private.secrets` 안 보임(404) / 기기 키 없는 readings·nodes·events(evt)·diagnostics 쓰기 거부(401, 42501) / `pump 1000`·`help`·`water 10; reboot` 거부(400, 23514) / `water 10` 허용 / 속인 status·created_at은 트리거가 덮어씀 / 기기 키 없이 명령 상태 변경·삭제는 0줄(RLS) / 10초 넘은 명령 `expired`(pg_cron 매분, 이번엔 15초 만에). 실행할 때마다 node `TEST` 명령 1줄이 남는다 (7일 뒤 자동 삭제)
- 확인된 것: 새 공개 키(`sb_`로 시작)는 **`apikey` 헤더 하나로** 동작한다 (`Authorization: Bearer`에는 넣지 않는다 — JWT가 아님). P2 펌웨어·P3 가짜 ESP32도 같게
- `secrets.h`에 WiFi·`DEVICE_KEY`까지 채워짐 (2026-10-23). `rpc/is_device`에 `x-device-key`를 보내 **true** 확인 → 맞는 키이고, 사용자 정의 헤더가 Supabase까지 전달된다. (사용자가 처음에 `sb_secret_` 키를 잘못 넣어 AI가 지우고 바로잡음)
- **아직 확인 못 한 것**: 기기 키로 readings 등 쓰기가 실제로 되는지 (P2/P3에서), Realtime 구독 (P4에서) → P2에서 권한·Realtime 알림은 노트북으로 확인 (3.6)

### 3.6 펌웨어 P2 — WiFi · Supabase 버전 `node-2.1` (2026-10-23, 실물 확인 대기)
- 파일: `node.ino`(센서·펌프·명령, 본 루프) + **`cloud.h`(새로: WiFi·Supabase, 코어 0의 FreeRTOS 작업)** + `config.h`(`USE_CLOUD 1/0`, flowcal 설정 추가) + `secrets.h`. 사용자 예전 프로젝트(`C:/Users/wlsgk/smartfarm-web/firmware`, HTTPClient+ArduinoJson, 네트워크는 코어 0)와 같은 구조. 예전 프로젝트와 다른 WiFi라 이 WiFi로 ESP32를 붙이는 건 처음
- 구조: 본 루프 → `cloudPost()`로 줄(FreeRTOS 큐)에 넣기만 → cloudTask가 HTTPS로 올림. **네트워크가 막혀도 펌프 끄기·센서는 안 막힘**(SAFE-01). WiFi 끊기면 측정값은 버리고(FW-09) 사건·결과는 연결되면 보냄. 시리얼 출력은 뮤텍스(`serialLine`)로 줄이 안 섞이게
- 올리는 곳: data → `readings`(t 키만 뺀 그대로), evt·info → `events`(payload=줄 전체), info·펌프 켜짐/꺼짐 → `nodes` upsert(fw·info·pump·day_ml), ack → `rpc/finish_command`
- 명령: **Realtime(WebSocket, links2004 WebSockets 2.7.2)**으로 commands INSERT(필터 `node=eq.Z1`)를 받으면 `rpc/claim_command`로 하나씩 가져와 실행. Realtime 연결 중엔 30초, 끊기면 2초마다 확인(FW-10). Phoenix 심장박동 25초. 노트북에서 Node로 같은 가입 메시지를 보내 **INSERT 알림이 0.1~0.5초에 오는 것 확인**(공개 키만으로, access_token 없어도 됨)
- `schema.sql` 추가(**사용자가 다시 실행해야 함**): `claim_command(p_node)`(기기 키 필요, 10초 넘은 pending → expired, stop 먼저, stop이면 대기 중 water·flowcal expired, `for update skip locked`), `finish_command(p_id, p_ok, p_result)`(sent일 때만 done/failed), nodes `updated_at`·`last_seen` 트리거(Supabase 시각), readings 입력 시 nodes `pump`·`last_seen` 갱신 트리거, cron에 "sent 뒤 3분 결과 없음 → failed(no_ack)" 추가
- 새로 한 것: `flowcal <ms>`(안정 무게(흔들림 ≤2g, 최대 10초) → 펌프 → 3초 뒤 최대 60초 안정 대기 → ack에 `before_g`·`after_g`·`delta_g`. stop·누수 등으로 멈추면 failed. 늘어난 g은 오늘 급수량에 더함), **오늘 급수량 NVS 저장 + NTP 한국 날짜**(시각 모르는 동안은 부팅 후 누적·저장 안 함, 시각을 알면 같은 날 저장값을 더하고 날짜 바뀌면 0), data `rssi`, info `cloud`(옛 `mqtt` 대신), 웹에서 온 `pump`·`help`는 `serial_only`로 거부, 보정·펌프 작업 중 다른 보정·펌프 명령은 `busy`, `reboot`는 결과를 보낸 뒤 재시작(최대 3초)
- 확인: arduino-cli(core 3.3.11, WebSockets 2.7.2, ArduinoJson 7.4.3, **HX711 Arduino Library 0.7.5(bogde)**, DHT 1.4.7)로 **컴파일 통과 88%**, `USE_CLOUD 0`(25%)·SHT31 A·B+12V+누수(48%)도 통과. 라이브러리는 scratchpad에 따로 받아 컴파일 (**사용자 PC의 Arduino 라이브러리 폴더에는 HX711·WebSockets가 없다** → README 2번으로 설치 안내). `check.mjs`에 기기 확인 추가: is_device true, readings·nodes를 구역 이름 `TEST!`로 보내 **권한 통과 후 이름 규칙(23514)에서 멈춤 = 기기 키·열 이름 일치**(행 안 남음)
- **2026-10-24 사용자 확인: 지금 배선은 SHT31 A·B 둘 다(21·22), 토양 A 32·B 33, HX711 26·27. DHT11은 뺐다** → `config.h`를 `USE_SHT31_A 1`, `USE_SHT31_B 1`, `USE_DHT11_A 0`으로 바꿈 (컴파일 90%). 부팅 때 `# 온습도 A/B (SHT31) 찾음/못 찾음` 줄을 출력 (B는 ADR→VIN이어야 0x45). 사용자 PC에 **Adafruit SHT31 Library도 없다** → 설치 안내
- **2026-10-25 WiFi 여러 곳**: 사용자가 학교·집을 오가며 쓴다 → `secrets.h`에 `WIFI_SSID2/PASSWORD2`, `WIFI_SSID3/PASSWORD3` 칸 추가(없어도 컴파일됨, 예시 값·빈 칸은 무시). `cloud.h`가 켜질 때·끊긴 뒤 15초마다 **주변을 훑어 등록한 것 중 가장 센 곳**에 붙고, 하나도 안 보이면 `# 등록한 WiFi(…)가 안 보여요. 지금 보이는 2.4GHz WiFi: "A", "B"`를 출력(이름을 그대로 옮겨 적게). 집 WiFi 칸은 **사용자가 직접 채울 차례**(채팅에 비밀번호 안 받음). 컴파일 91%
- 2026-10-25 Supabase 확인: `readings`·`nodes`·`events` 0줄, `claim_command` 없음(404) → 사용자가 아직 SQL 재실행·업로드 전
- **2026-11-03**: 사용자가 schema.sql 다시 실행함 → `node supabase/check.mjs` **전부 통과**(기기: claim stop 먼저·water expired·finish done/failed·중복 finish 거부·10초 만료). 사용자가 쇼트로 다른 센서를 빼고 **토양 A(32번)만** 꽂음 → `config.h`: SHT31 A·B·토양 B·HX711·펌프 0 (컴파일 88%, 쓰는 라이브러리 WebSockets·ArduinoJson뿐)
- **2026-11-03 supabase.com 대시보드가 이 노트북 네트워크에서 안 열림**(supabase.com 216.150.1.193 접속 시간 초과). 프로젝트 API(`luikttaomstcdvbdcmhk.supabase.co`)·status.supabase.com·vercel.com·*.vercel.app은 정상, Supabase 상태 페이지는 "All Systems Operational" → DB는 문제없음. 대시보드가 필요하면 폰 데이터(핫스팟)로 시도
- **2026-11-03 실물 확인 (P2 완료)**: 사용자가 업로드 성공 → Supabase `readings`에 **Z1이 5초마다**(seq 증가, `soil_a_mv` ≈2620, `soil_a` ≈ −0.09 = 토양 보정 전이라 기본 공기값 2500보다 높아 음수, `rssi` −39~−56), `events`에 boot·info, `nodes`에 Z1(fw node-2.1, last_seen 갱신). AI가 `commands`에 `info`를 넣자 **0.79초에 sent, 1.55초에 done** + result에 ack (Realtime → claim_command → finish_command 전체 경로 동작). 사용자 시리얼 모니터에는 처음에 안 보였음(속도·탭 안내함) — 보드 동작과는 무관
- **아직 못 한 것**: flowcal·급수 실측(펌프 없음), SHT31·HX711(쇼트로 빼 둠), 토양 보정(`soilcal a air/wet`), 학교 WiFi 외 집 WiFi(사용자 채울 차례)

### 3.7 웹 P4 — Supabase로 교체 (2026-11-03, 완료)
- `@supabase/supabase-js` 2.118.0. 새 파일: `src/lib/supabase.ts`(접속, 환경변수 없으면 `configError`), `src/lib/live.ts`(예전 `ws.ts` 대신), `src/lib/nodeState.ts`(행 → `NodeState`), `src/lib/commands.ts`(명령·정지·거부 이유 한국어). **지운 것**: `src/lib/ws.ts`, `src/lib/api.ts`, `vite.config.ts`의 `/api`·`/ws` 프록시 (웹은 이제 노트북 서버를 안 쓴다)
- `live.ts`: 시작·재연결(SUBSCRIBED)·화면 다시 켬 때 표를 한 번에 불러옴(nodes, latest_readings, 최근 10분 readings, events 200, diagnostics) → Realtime: readings·events INSERT, commands UPDATE, diagnostics `*`. **nodes 표는 구독 안 함**(측정값마다 touch 트리거로 바뀌어 Realtime 메시지가 2배가 됨) → info·pump_on/off·boot 사건이 오면 그 구역만 다시 읽음. 15초마다 `latest_readings`를 조회해 4초 넘게 놓친 값이 있으면 반영하고 다시 구독. 30초 넘게 끊겨 있으면 새로 구독
- 시계: (Realtime으로 받은 측정값의 created_at − 받은 시각) 최근 10개 최댓값을 `clockOffsetMs`로 → "n초 전"·끊김 판단이 기기 시계와 무관 (UI-11)
- `nodeState.ts`: 끊김 = 마지막 값이 max(15초, 3×sample_ms)보다 오래됨. 센서 상태는 **데이터가 말하는 것만**(읽기 실패 플래그 → 고장, 보정 전 → 정보) + diagnostics 표. 문구·기준값은 만들지 않음. `SensorState`에 `present`(info의 *_present) 추가 → 홈이 단 센서만 세고, 안 단 것은 "미설치"
- 타입 `src/types/api.ts`를 Supabase 행 모양으로 다시 씀 (ReadingRow·NodeRow·EventRow·CommandRow, `pc_time` → `created_at`, 예전 서버 전용 타입 삭제). 화면이 읽는 store 모양(`nodes`·`conn`·`events`·`recent`·`pumpProgress`)은 유지
- 화면: 정지 버튼 → `commands`에 구역마다 stop 넣고 바로 "n구역에 정지를 보냈어요", 결과가 실패·응답 없음이면 다시 알림. 섬 "서버 끊김" → "연결 끊김", 설정 없으면 "Supabase 설정 없음". 홈 헤더는 '정보'(보정 전)도 정상으로 셈. 온습도 A 옆 "none" 안 보이게. 펌프 안 달았으면 "미설치"(급수 버튼 숨김). 토양 B 없으면 "토양 A" + mV
- 확인: `npm run lint`·`npx tsc -b`·`npm run build` 통과. **실물 Z1로 headless Chrome(390×844)**: 2.2초에 Z1 표시, 토양값 실시간 변경(2642→2626mV), 섬 "1구역 연결", 콘솔 오류 0, 정지 버튼 → commands stop이 0.46초 sent·0.70초 done(`not running`). 브라우저 시계를 60초 앞당기면 "0/1구역 연결"·"끊김 · 마지막 값 1분 전", 새 값이 오자 복구
- **못 한 것**: 진단 서버(P6)가 없어 diagnostics 표는 비어 있음(진단 표시 경로는 실물 데이터로 확인 못 함), 급수·보정 화면(P5)은 아직 "준비 중"

### 3.8 P7 배포 (2026-11-03) + 보드 연결 불안정 발견
- Vercel(Hobby, 사용자 계정 wlsgks630-6699): 프로젝트 `chamgap`, GitHub `nanjinhan/chamgap` main, **Root Directory `web`, Preset Vite**, 환경변수 `VITE_SUPABASE_URL`·`VITE_SUPABASE_ANON_KEY`. 주소 **https://chamgap.vercel.app**. 푸시하면 자동 배포. Vercel이 저장소에서 `server`(FastAPI)도 찾아 "multi-service"를 권했지만 **web만 Import single project**. Vercel의 "Supabase Add" 통합은 **누르지 않음**(우리 Supabase를 이미 씀). 배포 때 Vercel이 이메일 코드로 재인증을 요구함
- `web/vercel.json`: 모든 경로 → `/index.html` (react-router 새로고침 404 방지). `/zone/Z1` 200 확인
- 확인: 배포 번들에 Supabase 주소·공개 키가 들어감, headless Chrome(390×844)으로 **1.3초에 Z1 표시, 1.4초에 Realtime 연결**, 콘솔 오류 0. GitHub에는 Vercel 배포 기록(deployments API)이 안 남음 → 확인은 주소로 직접
- **문제 발견 — 보드 WiFi가 자주 끊김**: 06:21~07:18 UTC 동안 와야 할 측정값 ~685개 중 547개만 들어옴(seq는 연속 = 재부팅 없음). 7초 넘는 빈틈 30번(8초~287초). WiFi 재연결 때 보내는 info 사건이 06:49·06:59·07:04·07:13·07:14·07:18에 옴 = **5~10분마다 WiFi 끊김**, 그 밖의 빈틈은 WiFi는 붙어 있는데 HTTPS 요청이 실패한 것으로 보임(측정값은 한 번만 시도하고 버림). RSSI는 −41~−56dBm으로 좋음. 07:18:42 뒤로는 7분 넘게 값이 없음(전원·WiFi 원인 모름 → 사용자에게 시리얼 `#` 줄 요청)
- **원인 후보 확인**: ESP32 core의 `NetworkClientSecure` TLS 핸드셰이크 기본 대기가 **120초**(`NetworkClientSecure.cpp` `handshake_timeout = 120000`). WebSockets 라이브러리 안의 SSL 클라이언트도 같아서, Realtime 재연결이 같은 cloudTask를 최대 2분씩 막아 측정값 올리기까지 멈췄을 가능성이 큼 (빈틈 30초~287초와 맞음)
- **고침 (2026-11-03, 컴파일 88%·경고 0, 실물 확인 전)**: ① `WiFi.setSleep(false)` ② REST `tls.setHandshakeTimeout(10)` ③ **Realtime을 별도 FreeRTOS 작업 `rtTask`(코어 0, 스택 12KB)로 분리** — 막혀도 측정값 올리기는 계속 ④ 측정값도 연결 오류면 새 연결로 1번 더 ⑤ 스스로 고치기: WiFi는 붙었는데 3분 넘게 Supabase 응답이 없으면 WiFi 재연결, 10분 넘으면 본 루프가 펌프·보정 작업이 없을 때 `ESP.restart()` ⑥ info에 `wifi_drops`·`wifi_reason`·`net_fail`·`rt`·`heap`·`heap_min`·`up_s` + **10분마다 info 보고** → `nodes.info`로 원격 진단
- 2026-11-03 07:18:42 UTC 뒤로 보드 값이 계속 없음. 사용자 시리얼(예전 펌웨어, 켜진 지 75분): `# 등록한 WiFi(학교 WiFi 이름)가 안 보여요. 지금 보이는 2.4GHz WiFi: 없음`이 15초마다 → **진짜 원인: 다시 붙는 중에는 `WiFi.scanNetworks()`가 실패(음수)하는데, `wifiConnect()`가 그때 `WiFi.begin()`을 안 부르고 포기해서 다시 연결을 영영 못 함** (사용자 노트북의 WiFi·공유기는 정상)
- **고침 (컴파일 88%, 실물 확인 전)**: 훑기가 실패하거나 등록한 WiFi가 안 보여도 등록한 WiFi에 차례로 `WiFi.begin()`(round-robin), 훑기 3번 연속 실패면 `WiFi.mode(OFF→STA)`로 장치 재시작, **WiFi가 10분 넘게 안 붙으면 `ESP.restart()`**(펌프·보정 작업 없을 때). 사용자에게 업로드 요청
- 이 노트북 네트워크에서는 supabase.com(대시보드, 216.150.1.193)만 접속 시간 초과, *.supabase.co API와 vercel.app은 정상

### 3.9 새 디자인 (사용자 제공 `design/*.jpg` 9장, 2026-11-03~)
- 사용자: "디자인 싹 갈아엎자, 여기 디자인하고 똑같게". **예전 와이어프레임(`docs/design/wireframe/`)과 연하늘·흰 카드 톤은 버린다.** 새 톤: 회색·초록 사진 배경 위 유리 카드, 연두 포인트(#cdee74), 흰 얇은 글자(Pretendard, 영문은 큰 Light), 머리글 `CHAMGAP` + `— MENU`
- 9장: 00 홈 / 01 구역 상세(지표 카드 4·A/B 비교·최근 활동·바로가기 4) / 02~04 센서 상세 탭(온습도·토양수분·무게, 그래프) / 05 급수 화분 고르기 / 06 급수 제어(10~50mL 칩) / 07 급수 중(원형 진행·중지) / 08 급수 완료(결과·전후 무게)
- 진행: **D1 공통 틀 + 홈 → (사용자 요청으로 한 번에) D2 구역 상세 · D3 센서 상세 3탭 · D4 급수 4화면 · 넓은 화면 2단 — 모두 완료 (2026-11-03)**. 남은 화면(진단·기록·설정·보정 마법사)은 아직 '준비 중'
- **D1 (2026-11-03)**: 토큰 `--ds-*`(tokens.css), 글꼴 Pretendard(`pretendard` npm, dynamic subset)로 교체·옛 글꼴 패키지 삭제, `TopBar`(뒤로·CHAMGAP·정지·MENU)+`MenuSheet`(홈·급수·진단·기록·설정, Esc 닫기) — **아래 메뉴줄·검은 섬·예전 홈 카드 삭제**(`BottomBar`·`StatusIsland`·`ZoneCarousel`·`SensorTile`), 홈 `HomePage.tsx` 다시 씀(큰 `Z1`/식물 이름, 사진 위 온도·습도·토양·무게 + 범위 막대, 구역 동그라미 Z1~Z3(고른 구역 연두 고리 = 토양 수분, 다시 누르면 구역 상세), 오늘 급수량 카드 + 급수하기). 연결 끊김은 머리글 아래 줄 + 홈 부제(`연결 끊김 · 마지막 값 n분 전`)
- 사진: `design/`에서 잘라 `web/public/design/`에 둠(`home-hero.jpg` = 홈 사진, 박힌 측정값 글자는 위아래 배경색 보간으로 지움 / `plant-z1~3.jpg` = 05 화면 카드 사진). 자른 스크립트는 scratchpad(Pillow) — 다시 만들 때는 같은 좌표로. 더 좋은 사진이 생기면 같은 이름으로 바꾸면 됨
- 구역 식물 설정 `web/src/config/zones.ts`: Z1 Monstera(몬스테라), Z2 Pothos(스킨답서스), Z3 Sansevieria(산세베리아) — 디자인 01은 Z2 스투키·Z3 필로덴드론이라 서로 달라 05(사진 있는 쪽)를 따름. **사용자 확인 필요**
- 디자인과 다르게 한 것(이유): ① 머리글에 빨간 **'정지' 알약**(SAFE-06: 모든 화면에서 한 번에, 디자인엔 없음) ② 값이 없으면 `--` + 막대 아래 '미설치'/'보정 전' ③ '+' 동그라미는 구역 추가 안내 알림만(구역은 ESP32를 켜면 자동으로 생김)
- 앞으로 디자인에 있지만 데이터가 없는 것(D4 등에서 정할 것): 물통 잔량 75%(센서 없음), 목표 급수량 편집(하루 300mL는 펌웨어 고정), 토양 '온도 보정값 자동 보정'(없는 기능), '적정 범위 0.40~0.80'(식물별 설정 — 웹이 판정하면 안 되는 진단 기준과 구분 필요), 급수 버튼은 **1초 길게 누르기 유지**(SAFE-05)
- 확인: `tsc -b`·`lint` 통과, 390×844 스크린샷을 디자인 00과 나란히 비교(배치·크기 거의 같음), 메뉴·하위 화면·1280px 폭 확인, 콘솔 오류 0
- **D2~D4 + 반응형 (2026-11-03, 사용자: "디자인 많이 놔뒀는데 왜 메인만?", "반응형이 아니라 폰 구조 하나만 뜬다")**
  - 새 공통 부품 `web/src/components/ds/ui.tsx`(Panel·Cell·PanelHeader·RangeBar·StatusLabel·ZoneTitle·PillTabs·ZonePills·LimeButton·GhostButton·**HoldButton(1초 길게, SAFE-05)**·CornerPlant), 그래프 `ds/charts.tsx`(recharts: TrendChart·BarsChart·Sparkline·ChartEmpty, 연두 A·흰 B)
  - 데이터 도우미: `lib/readings.ts`(온도·습도·토양은 **A·B 평균**을 큰 숫자로, 센서별 상태 글자 미설치·끊김·고장·보정 전·정상), `lib/history.ts`(Supabase `history()` 훅, 한국 날짜 기준 하루 평균·최저/최고/평균), `lib/activity.ts`(사건 → 최근 활동 문구), `lib/precheck.ts`(급수 전 점검 SAFE-03 순서 미러, 안내만)
  - 화면: `ZonePage`(구역 상세: 사진·구역 알약·지표 카드 4·A/B 흐름·최근 활동·바로가기 4), `SensorPage`(`/zone/:node/sensor/climate|soil|weight`, 예전 sht_a 등 주소는 넘겨줌: 온습도 현재값·스와이프로 온도↔습도·날짜 고르기·하루 그래프·A/B 비교 / 토양 배너·A/B 캡슐 게이지·7일 막대·mV·보정 상태 / 무게 kg·게이지·7일 선·일/주/월 막대), `WaterPage`(`/water` 화분 고르기 → `/water/:node` 제어(10~50mL·점검·1초 길게) → 진행(원형·남은 초·중지·최근 급수 기록) → 완료(요청/실제 mL·무게 변화·전후 비교, 급수 전 무게는 펌프 켜지기 직전 측정값))
  - 디자인과 다르게 한 것: 진단 문구 지어내지 않음('지금도 건강하게 자라고 있어요' → 데이터 사실 문장), '온도 보정값 자동 보정' → 실제 토양 보정값(공기·물 mV)·보정 상태, '물통 잔량' → '센서 없음', '목표 급수량 편집' → '하루 한도 300mL'(펌웨어 고정), 급수 판정 '정상'은 진단 서버 water_result가 있을 때만(없으면 '끝까지 급수함/중간에 멈춤' 사실)
  - 반응형: 폰(≤1023px)은 디자인 그대로 한 줄, 노트북(≥1024px)은 최대 1160px 2단(홈: 왼쪽 제목·구역·급수 / 오른쪽 큰 사진, 하위 화면: 왼쪽·오른쪽 카드). 여백: 홈 26px, 하위 화면 16px(디자인 실측). 사진 가장자리는 테두리까지 완전히 흐리게(`.hero-fade`, CornerPlant)
  - 사진 추가 자르기(`web/public/design/`): `soil-banner.jpg`(04 흙), `weight-pot.jpg`(05 저울 위 화분), `leaves-top.jpg`(09 잎). 홈 사진 `home-hero.jpg`를 구역 상세·급수 제어 큰 사진으로도 씀
  - 확인: `tsc -b`·`lint`·`build` 통과. headless Chrome으로 9개 화면을 390×844·1440×900에서 찍어 디자인과 나란히 비교(값이 비어 있어 **브라우저 store에만 예시 값을 넣어** 확인, 그래프는 `history` 요청을 예시 기록으로 가로채 확인 — Supabase에는 쓰지 않음). 콘솔 오류 0. 확인 스크립트는 scratchpad(`all_shots.mjs`, `chart_shots.mjs`)
  - 남은 일 ②③④는 아래 '남은 화면 4개'에서 끝냄. 남은 것: ① GitHub 푸시 → Vercel 반영(사용자 확인 후) ⑤ 실물 급수 흐름은 펌프·로드셀 단 뒤 확인 ⑥ 사용자 피드백 ⑦ 기록 그래프에 급수 시점 세로선(디자인 W9) 아직 없음 ⑧ (선택) P6 진단 서버
- **남은 화면 4개 (2026-11-03 밤, 사용자 "이어서 만들어")** — 같은 톤으로 완성, `Placeholder`·시험 모드(`/test`, `TestPage`) 삭제
  - **보정 마법사** `/calibrate/:node/soil|scale|flow` (`/calibrate/:node`는 soil로): 단계 표시 + 지금 값(최근 측정값 20초 안 흔들림으로 '안정됨') + 명령 → **ack ok여야 다음 단계**, 실패면 이유(한국어)와 그 단계 유지, 실행 중 'n초 (최대 m초)'. 토양: A/B 고르기 → `soilcal a air` → `soilcal a wet` → 공기−물 ≥ 500mV면 완료. 로드셀: `tare` → 무게 입력 `cal <g>` → ±2% 확인. 유량: 펌프·로드셀·로드셀 보정 필요, **1초 길게 눌러** `flowcal 10000` → delta_g → `flow 10000 <g>` 저장. 오른쪽(노트북)/아래(폰)에 '지금 저장된 보정값'. 구역이 끊겨 있으면 버튼 막음
  - **기록** `/history/:node`: 구역 알약, 기간 1·6·24시간·7일(60/300/900/3600초 평균), 지표 토양·온도·습도·무게(A 연두·B 흰 선), 'n시간 동안 +0.14 (A 센서)' 요약, 사건·메모(`events` t='mark' 넣기, 그 기간 사건 100개), **CSV**(엑셀 BOM·한글 머리글, 6시간 이하는 원래 측정값(1000줄씩 최대 6000줄), 더 길면 평균)
  - **진단** `/diagnostics`: 진단 서버 켜짐 여부(`service_status` 2분 안 기록, `lib/diagServer.ts`), 꺼져 있으면 안내, 고장·주의·정보 거르기, 진단 카드(진단 서버 것만), **'연결·보정 상태(진단 아님)'** = 끊김·신호 없음·보정 전·값 못 읽음 사실 + 보정하기 링크, 해결된 진단(diag_off)
  - **설정** `/settings`: 연결(Supabase·마지막 값·진단 서버·주소), 화면(움직임 줄이기), 안내, **구역별 보드 상태**(펌웨어·WiFi 세기·켜진 지·WiFi 끊긴 횟수·마지막 이유(200=공유기 신호가 사라짐 등)·HTTPS 실패·남은 메모리) + 측정 주기 5/10/30초(`interval`) + 설정 다시 받기(`info`)
  - 홈: 측정값을 구역 상세처럼 **A·B 평균**으로 맞춤(`readings.values()`), 구역 고리도 평균 토양 수분
  - 타입: `InfoMsg`에 wifi_drops·wifi_reason·net_fail·rt·heap·heap_min·up_s. `toLiveEvent`를 store에서 내보냄(기록 화면이 events 행을 그대로 바꿔 씀)
  - 확인: tsc·lint·build 통과, 4화면 + 홈을 390×844·1440×900으로 찍어 확인(예시 값은 브라우저 store에만, `history`는 가로챈 예시 기록), 콘솔 오류 0. 실제 보드가 꺼져 있어 **보정 명령을 실물로 보내 보지는 못함**
- **홈에서 하위 화면 가는 길 (2026-11-03 밤, 사용자: "디자인 8개인데 배포 화면 들어가면 두 개밖에 없어")**: 고장은 아니고 길이 안 보였음(구역 상세는 '선택된 동그라미 한 번 더'로만, 센서 상세는 구역 상세 안에서만, 급수 진행·완료는 실제 펌프가 돌 때만). → 홈 큰 제목·부제 옆 '상세 보기 ›' → 구역 상세, 사진 위 온도·습도·토양·무게 숫자 → 해당 센서 상세 탭. 급수 진행·완료(디자인 08·09)는 이때까지 실제 펌프가 돌 때만 보였음 → 바로 아래 '급수 화면 세 주소'로 고침
- **급수 화면 세 주소 (2026-11-03 밤, 사용자: "펌프가 돌 때만 앱이 작동하는 게 어디 있어, 펌프 안 돌아도 있어야지")** — 급수 진행·완료가 펌프가 돌 때만 잠깐 나타나던 것을 **언제든 들어가는 화면**으로 나눔 (`WaterPage.tsx`, 주소 `water/:node/:view` 추가)
  - `/water/Z1` **급수 제어(07)**: 그대로 + 아래에 '급수 상태 ›'·'지난 급수 결과 ›', 펌프가 돌고 있으면 위에 '지금 급수 중이에요 · 진행 보기 ›'. 1초 눌러 `water` 명령이 ok면 **상태 화면으로 이동**
  - `/water/Z1/now` **급수 상태(08)**: 평소엔 '대기 중' 원 + 오늘 n/300 mL + '급수하러 가기', 펌프 대기·남은 시간 --·물통 잔량 '센서 없음', 최근 급수 기록 4개. 펌프가 돌면 **같은 화면에서** 원이 차오르고(`pump.started_at`·`dur`·`ml`), '급수 중지하기'(`stop`), 펌프가 멈추면 결과 화면으로 자동 이동
  - `/water/Z1/result` **급수 결과(09)**: **Supabase에서 마지막 급수**를 찾음(`events` pump_on/pump_off 20개 → 마지막 pump_off와 1분 안의 pump_on, 무게는 켜지기 직전 마지막 값·꺼지고 3초 뒤 첫 값(10분 안)). 요청량(pump_on의 ml)·실제량(pump_off의 ml, 펌프가 돈 시간으로 계산)·무게 변화·전후 비교. 무게 센서 없으면 '무게 센서 미설치'. 급수 직후 '급수 후' 무게가 아직 없으면 10초마다 다시 찾음. 기록이 없으면 '아직 급수 기록이 없어요' + '급수하러 가기'
  - 홈 급수 카드: '오늘 급수량' 옆 '급수 상태 ›', 펌프가 돌면 버튼이 '급수 중 →'(상태 화면)
  - 홈 폰 화면이 **가로로 18px 넘치던 것** 고침(오른쪽 토양·무게 숫자 칸이 79.5% 위치 + 25% 너비 = 104.5%) → 폰에서는 오른쪽 끝 6px에 붙임, 숫자·단위 한 줄. 390·360·1440 너비에서 넘침 0 확인
  - 확인: tsc·lint·build 통과. 390×844·1440×900으로 대기·급수 중·결과(가로챈 예시 기록)·기록 없음(실제 DB = 아직 급수 기록 없음)·제어 화면(급수 중 알림)·홈(급수 중) 찍어 확인, **펌프가 멈추면 `/water/Z1/result`로 넘어가는 것** 확인, 콘솔 오류 0. 예시 값은 브라우저 store에만 넣음. **실물 펌프로는 확인 못 함**(펌프 없음)
- **보드 WiFi (같은 날)**: 원격 진단으로 07:55에 `wifi_drops=1, wifi_reason=200(BEACON_TIMEOUT), net_fail=3` 확인, 그 뒤 재시작해도 신호 없음 → **공유기(학교 WiFi) 자체가 사라졌다 돌아오는 것으로 의심**(사용자가 "와이파이 다시 함" 직후 붙었음). 휴대폰 핫스팟·휴대용 공유기인지 사용자에게 물음

---

## 4. 앞으로 할 일 (새 순서)

각 단계는 **하나씩** 하고 멈춘다. 끝나면 `[ ]`를 `[x]`로 바꾼다.

- [x] **P0. 요구사항지시서 v2.0** — 작성 완료 (2026-10-23). **사용자 확인 대기.** 고칠 점이 있다고 하면 지시서부터 고친다.
- [x] **(추가) USB 연결 먼저** — 지금 단 센서만으로 펌웨어 → USB → 노트북 서버 → 웹. 완료 (실물 확인은 사용자).
- [x] **P1. Supabase 준비** — 완료 (2026-10-23). 자세한 내용은 3.5
  - [x] 사용자가 Supabase 조직·프로젝트 생성, `supabase/schema.sql` 실행
  - [x] 공개 키(Publishable)를 `secrets.h`의 `SUPABASE_KEY`, `web/.env.local`의 `VITE_SUPABASE_ANON_KEY`에 넣음
  - [x] `node supabase/check.mjs` 23개 항목 모두 통과 (진짜 공개 키로)
  - [x] `secrets.h`의 WiFi 이름·비밀번호·DEVICE_KEY 채움 (DEVICE_KEY는 `is_device()`=true로 확인)
- [x] **P2. ESP32 펌웨어** — 완료 (2026-11-03, 실물 Z1·토양 A만으로 값 올리기·명령 done 확인). 자세한 내용은 3.6
  - [x] `node.ino` + `cloud.h` + `config.h`, README(라이브러리·올리기·확인·문제 해결), `schema.sql`에 ESP32용 함수, `check.mjs` 기기 확인
  - [x] 사용자: `supabase/schema.sql` 다시 실행 → AI가 `node supabase/check.mjs`로 claim/finish 확인 (2026-11-03 모두 통과)
  - [x] 사용자: 라이브러리 설치(WebSockets) → 업로드 성공
  - [x] AI: Supabase에서 Z1 `readings`가 5초마다 들어옴, `info` 명령 1.55초에 `done` 확인
  - (나중) 쇼트로 빼 둔 SHT31·HX711·펌프를 다시 달면 `config.h`에서 켜고 실물 확인 (flowcal·급수 포함)
  - (선택, 안 함) 센서 시험 스케치 `firmware/00_i2c` ~ `05_pump`
- [ ] **P3. 하드웨어 없이 확인하는 가짜 ESP32** — (2026-11-03 사용자 목표 변경으로 **미룸**: 실물 Z1로 먼저 배포까지) — `server/`의 mock ESP32를 재사용해 Supabase에 펌웨어와 똑같이 값을 올리고 명령에 응답하는 스크립트. 실물 없이 웹을 개발·시연하기 위함.
- [x] **P4. 웹 데이터 계층을 Supabase로 교체** — 완료 (2026-11-03, 실물 Z1로 확인). 자세한 내용은 3.7. (처음 계획:) `@supabase/supabase-js`, 실시간 구독(readings·events·commands·nodes), 명령 넣기·결과 기다리기. **store 모양(`NodeState` 등)은 유지**해서 이후 화면 코드는 그대로 쓴다. 환경변수 `VITE_SUPABASE_URL`, `VITE_SUPABASE_ANON_KEY` (`web/.env.local`, git 제외).
- [ ] **P5. 웹 화면** — **2026-11-03부터 사용자 새 디자인 `design/*.jpg` 기준(3.9)**: 9개 화면 + 보정·기록·진단·설정 완료, 급수 상태·결과를 언제든 보는 주소(`/water/:node/now|result`) 완료. 남은 것: 기록 그래프의 급수 시점 세로선, 실물 펌프·로드셀로 급수 흐름 확인. (아래 W4~W11은 예전 와이어프레임 기준 계획이라 참고만) 프롬프트 ②의 W4~W11 설명은 보조로 쓴다. Supabase 기준 조정:
  - W4 Dynamic Island (연결 끊김 / 급수 중 / 고장 / 주의 / 정상)
  - W5 홈 + 진단 목록 + 모두 정지 동작 (진단이 없으면 진단 목록은 "진단 서버 꺼짐" 안내)
  - W6 구역 상세(원형 게이지, A·B 비교, 미니 그래프) + 센서 상세
  - W7 급수 (Elastic Slider, 1초 Hold Button, 급수 중 정지, 결과). 사전 점검은 웹에서 계산해 **안내만** 하고 최종 거부는 ESP32
  - W8 보정 마법사 (로드셀·토양·유량). 명령 결과가 ok여야 다음 단계
  - W9 기록 (그래프는 Supabase 평균 함수, CSV는 웹에서 만듦)
  - W10 설정 (+ 가짜 ESP32 고장 재현은 P3 스크립트 쪽). 시험 모드(USB 원시 명령)는 노트북 서버가 있을 때만 → 범위에서 뺄지 P0에서 정함
  - W11 노트북 대시보드(≥1024px), 접근성·성능 점검
- [ ] **P6. (선택) 진단 서버** — 파이썬 서버에 `links/supabase_link.py`를 추가해 Supabase 값을 읽고, 진단 엔진 결과를 `diagnostics` 표에 기록. 웹은 그 표를 구독해 표시. 서버가 꺼져 있어도 값 보기·버튼은 동작.
- [ ] **P7. 배포·실물 확인** — **배포 완료 (2026-11-03, https://chamgap.vercel.app, 3.8)**. 실물 급수 확인은 펌프·로드셀을 다시 단 뒤. (처음 계획:) 사용자는 **일찍 배포해 두고 고칠 때마다 자동 반영**되기를 원한다: GitHub 저장소 + Vercel 연결(푸시하면 자동 배포). 단, Vercel 사이트는 노트북 서버에 닿지 못하므로 P1·P4(Supabase) 뒤에 데이터가 보인다. git 저장소·GitHub(https://github.com/nanjinhan/chamgap)는 있다. 사용자 Vercel 계정(Hobby, 다른 프로젝트 여러 개)에 "New repository detected → Import" 카드가 떠 있다 — P4 뒤에 Import(Root Directory `web`, 환경변수 2개). — Vercel에 `web/` 올리기(환경변수 설정), 실물 ESP32 Z1 하나로 "급수 → 무게 증가 → 수분 상승"까지 웹에서 확인, 이어서 3구역.

---

## 5. 제안 설계 (P1·P2에서 확정)

> 확정된 표·함수·권한은 **`supabase/schema.sql`이 기준**이다 (아래는 처음 제안이라 열 이름이 조금 다르다: readings는 `extra jsonb`, events는 `t`·`ev`·`payload`). 명령은 ESP32가 Realtime 알림을 받고 `rpc/claim_command`로 가져간다 (3.6).

### 5.1 Supabase 표
| 표 | 쓰는 쪽 → 읽는 쪽 | 내용 |
|---|---|---|
| `readings` | ESP32 → 웹 | 주기 측정값 한 줄 = 한 행. 열은 지시서 4.2 `data` 키 그대로 (`node, seq, temp_a, rh_a, temp_b, rh_b, soil_a_mv, soil_a, soil_b_mv, soil_b, hx_ok, weight_g, weight_sd, v12, leak, pump, rssi`) + `created_at`(서버 시각) + `raw jsonb` |
| `events` | ESP32 → 웹 | `boot`, `pump_on`, `pump_off`, `refused`, `info` 등 (`node, kind, payload jsonb, created_at`) |
| `nodes` | ESP32 → 웹 | 구역별 마지막 상태·보정값(`info` 내용), `last_seen`. ESP32가 upsert |
| `commands` | 웹 → ESP32 → 웹 | `id, node, cmd('water 10' 같은 지시서 4.3 명령 문자열), status(pending→sent→done/failed/expired), result jsonb(ack), created_at, done_at` |
| `diagnostics` | 진단 서버 → 웹 | (P6 선택) 지시서 6.2 형식 |

### 5.2 명령 흐름과 안전
1. 웹이 `commands`에 `pending`으로 넣는다 (허용 명령만: water, stop, tare, cal, soilcal, flow, interval, info, status, reboot, flowcal — DB CHECK 제약으로 막는다).
2. ESP32가 1~2초마다 자기 구역의 `pending`을 가져가 `sent`로 바꾸고 실행, ack를 `result`에 넣고 `done`/`failed`.
3. **만든 지 10초가 넘은 명령은 실행하지 않고 `expired`** (ESP32가 꺼져 있다 켜졌을 때 오래된 급수 명령이 실행되는 사고 방지).
4. ESP32 안전(최종 판단, SYS-02 유지): 부팅 시 펌프 OFF, 1회 최대 15초 후 스스로 끔, 12V 없음·누수면 거부·즉시 끔, 끈 뒤 3초 쉬기, **하루 300mL 한도와 유량 보정 확인도 ESP32가** (하루는 NTP 시각 기준).
5. `stop`은 다른 명령보다 먼저 처리.
6. 로그인이 없으므로 anon key로 누구나 `commands`에 넣을 수 있다. 쓰기 권한은 RLS로 최소화하고, ESP32가 쓰는 표(readings 등)는 **기기 비밀값 헤더**(예: `x-device-key`)를 RLS 조건으로 확인하는 방식을 검토한다.

### 5.3 무료 등급에서 주의할 것 (P1에서 최신 정책 확인)
- 5초 × 3구역 ≈ 하루 5만 행 → 무료 DB 용량(약 500MB)을 몇 주 만에 채울 수 있다 → **보관 기간(예: 14일) 자동 삭제** 또는 주기 늘리기.
- 무료 프로젝트는 오래 쓰지 않으면 일시정지될 수 있다 (정책 확인 필요).
- ESP32 HTTPS: 처음에는 `WiFiClientSecure::setInsecure()`로 단순하게, 이후 루트 인증서 고정 검토.

### 5.4 하드웨어 (지시서 1.3 그대로 가정 — 8장 질문 3으로 확인)
SHT31 A 0x44 / B 0x45 (SDA21·SCL22), SEN0193 A GPIO32 / B GPIO33, HX711 DT26·SCK27, 펌프 DFR0457 GPIO25(+10kΩ 풀다운), 12V 감지 GPIO34(47k/10k), 누수 GPIO35(선택). 보정값은 NVS 이름공간 `chamgap`.

---

## 6. 지금 상태에서 실행하는 법 (Windows)

```bat
:: (예전) 파이썬 서버 — 새 구조의 웹은 더 이상 쓰지 않는다. USB 시리얼 확인·진단 엔진(P6)용
cd server
.venv\Scripts\activate
python -m chamgap --mode mock --mock-speed 5      :: http://localhost:8000/docs

:: 웹 (Supabase에서 바로 받음, 서버 필요 없음. web/.env.local 필요)
cd web
npm run dev                                        :: http://localhost:5173  (데모: /dev/fx)

:: 확인
cd server && pytest && ruff check .
cd web && npm run lint && npx tsc -b && npm run build
node supabase/check.mjs                            :: Supabase 권한·명령 흐름 (web/.env.local, firmware/node/secrets.h 사용)
```
- **펌웨어 컴파일(AI가 할 때)**: Arduino IDE에 들어 있는 `%LOCALAPPDATA%/Programs/Arduino IDE/resources/app/lib/backend/resources/arduino-cli.exe`를 쓴다. 사용자 라이브러리 폴더(`OneDrive/문서/Arduino/libraries`)를 건드리지 않으려고 scratchpad에 `directories.user`만 바꾼 설정 파일을 만들고 라이브러리(WebSockets, ArduinoJson, HX711 Arduino Library, Adafruit SHT31 Library, DHT sensor library, Adafruit Unified Sensor)를 거기에 받아 `compile --fqbn esp32:esp32:esp32 firmware/node`로 확인했다. ESP32 core 3.3.11은 이미 설치돼 있다.
- 서버 가상환경이 없으면 `server\run_server.bat`이 만들어 준다. 웹은 `npm install` 필요.
- 개발 환경: Python 3.12, Node 24, npm 11, Windows 11. 브라우저 화면 확인은 playwright-core + 설치된 Chrome(`C:/Program Files/Google/Chrome/Application/chrome.exe`)으로 스크린샷을 찍어 했다 (도구는 프로젝트에 넣지 않음).

---

## 7. 지킬 관례

- **웹**: TS strict, `any` 금지. `src/components/react-bits/`·`src/components/ui/` 원본은 고치지 않고 `src/components/fx/` 래퍼를 쓴다 (꼭 고치면 `// MODIFIED:` 주석). 모든 래퍼는 움직임 줄이기 지원. 상태는 색+글자+아이콘(UI-05). **모두 정지 버튼은 모든 화면에 항상, 확인 창 없이. 급수는 1초 길게 누르기로만.** 진단 문구를 웹에서 지어내지 않는다 (진단 서버가 주는 것만 표시).
- **서버**: ruff 기본 규칙, pytest, 시간은 `Clock` 주입(테스트에서 건너뛰기).
- **펌웨어**: 비밀값(WiFi 비밀번호, Supabase 키, 기기 비밀값)은 `secrets.h`에만, 저장소에는 `secrets.example.h`만. 시리얼(115200, 한 줄 JSON) 출력은 계속 유지해 USB로도 볼 수 있게.
- **웹 환경변수**: `web/.env.local` (git 제외), Vercel에는 프로젝트 설정의 Environment Variables로.
- 단계가 끝나면 이 문서 3장·4장을 갱신한다.

---

## 8. 사용자에게 확인할 것 (열린 질문)

1. ~~진단 기능~~ → 정함: (가)를 먼저 끝까지, (나) 진단 서버는 P5 뒤에 할지 정한다.
2. ~~Supabase 프로젝트~~ → 완료 (3.5).
3. **실제 하드웨어 구성**: Z1 배선은 확인됨(2026-10-24: SHT31 A·B 21·22, 토양 32·33, HX711 26·27). **아직 모름**: 펌프(25번)를 달았는지, 12V 감지·누수 센서를 쓰는지(지금 `config.h`에서 0), 구역이 정말 3개인지.
4. ~~WiFi~~ → 현장 WiFi 이름·비밀번호는 `secrets.h`에만 있다 (공개 저장소라 문서에 적지 않는다). 2.4GHz인지는 실물로 확인 전.
5. ~~예전 아두이노 코드~~ → 이 노트북 `C:/Users/wlsgk/smartfarm-web/firmware`에서 찾음 (HTTPClient+ArduinoJson, 코어 0 네트워크 작업). 참고만 했다.
6. 지시서 v2.0에서 웹 시험 모드는 **제외**로 정했다 — 사용자가 다르게 원하면 되돌린다.
7. 지시서 v2.0에서 새로 정한 값들이 괜찮은지: 명령 만료 10초, 데이터 보관 14일, 측정 주기 5초(한도에 가까우면 10초), 하루 300mL·1회 50mL.

---

## 9. 파일 지도

```
chamgap/
├─ CLAUDE.md                   새 채팅이 자동으로 읽는 안내 (이 문서로 보냄)
├─ docs/
│  ├─ 01_requirements.md       요구사항지시서 **v2.0** (Supabase 구조)
│  ├─ archive/01_requirements_v1.0.md  원래 v1.0 (노트북 서버 구조)
│  ├─ 02_PROMPT_server.md      원래 서버 작업 지시 (S1~S9, 완료)
│  ├─ 03_PROMPT_webapp.md      원래 웹 작업 지시 (W1~W12, W3까지 완료)
│  ├─ 04_이어서_만들기.md      ← 이 문서
│  ├─ 05_앱_디자인_브리프.md   앱·웹 재디자인용 설명서 (데이터·상태·안전 규칙·화면별 필수 요소·바꿔도 되는 것) — 2026-10-24 사용자가 재디자인하려고 요청
│  └─ design/wireframe/        사용자 와이어프레임 01~10 (png 캡처 + 원본 html). 화면은 이것을 그대로 따른다
├─ firmware/node/              ESP32 펌웨어 node.ino·cloud.h(WiFi·Supabase)·config.h·secrets.h(git 제외), README(설치·올리기)
├─ supabase/                   schema.sql(표·권한·자동 정리), check.mjs(권한 확인), README(가입·실행 안내)
├─ server/                     파이썬 브리지 서버 (S1~S9 완료, README에 실행법·시나리오·TODO)
│  ├─ chamgap/                 protocol·hub·commands·safety·storage·ws·links(serial/mqtt/mock)·diagnostics
│  └─ tests/                   220개
└─ web/                        React 웹앱 (W1~W3 완료)
   ├─ COMPONENTS.md            React Bits·cult-ui 설치/대체 표
   └─ src/
      ├─ components/{react-bits,ui}  설치 원본 (고치지 않음)
      ├─ components/fx/              래퍼
      ├─ components/layout/          AppShell, TabBar, DesktopDock, StopAllButton, ScreenHeader
      ├─ features/                   화면별 폴더 (대부분 아직 "준비 중")
      ├─ lib/{supabase,live,nodeState,commands}.ts  Supabase 접속·실시간·구역 상태·명령 (P4)
      ├─ store/                      useAppStore(실시간 상태), useSettings, useToasts
      └─ types/api.ts                지시서 4.2·5.3·6.2 형식
```
