nanjinhan/chamgap/docs/design/wireframe/README.md

# 와이어프레임 (사용자 제공, 2026-10-23)

- `참값 웹앱 와이어프레임.html` — 원본 (브라우저로 열면 10장이 모두 보임)
- `png/01.png ~ 10.png` — 각 장의 390×844(10번은 1280×860) 화면 캡처
- `src/NN.src.html` — 각 장의 HTML 원본 (글꼴 데이터만 뺌). **색·크기·간격은 여기의 인라인 스타일을 그대로 따른다**

| 번호 | 화면 |
|---|---|
| 01 | 홈 (전체 현황) |
| 02 | 구역 상세 |
| 03 | 센서 상세 + 진단 |
| 04 | 급수 |
| 05 | 진단 목록 |
| 06 | 보정 마법사 |
| 07 | 기록·그래프 |
| 08 | 시험 모드 (스케치 00~05) |
| 09 | Dynamic Island 상태 |
| 10 | 노트북 시연 화면 |
