nanjinhan/chamgap/design/KakaoTalk_20261103_165435064.jpg

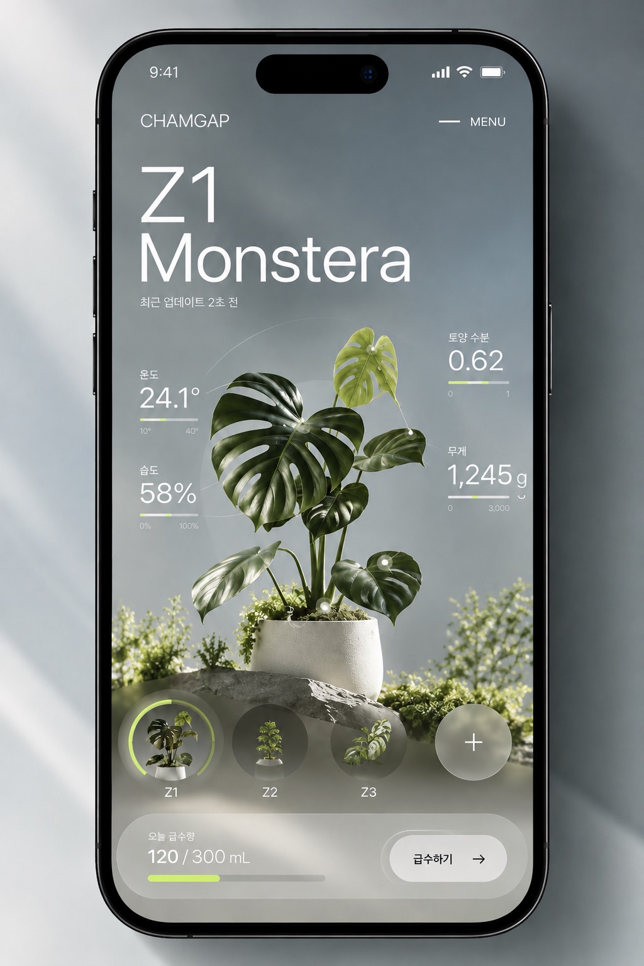
design/KakaoTalk_20261103_165435064.jpg
