nanjinhan/chamgap/design/KakaoTalk_20261103_165435064_04.jpg

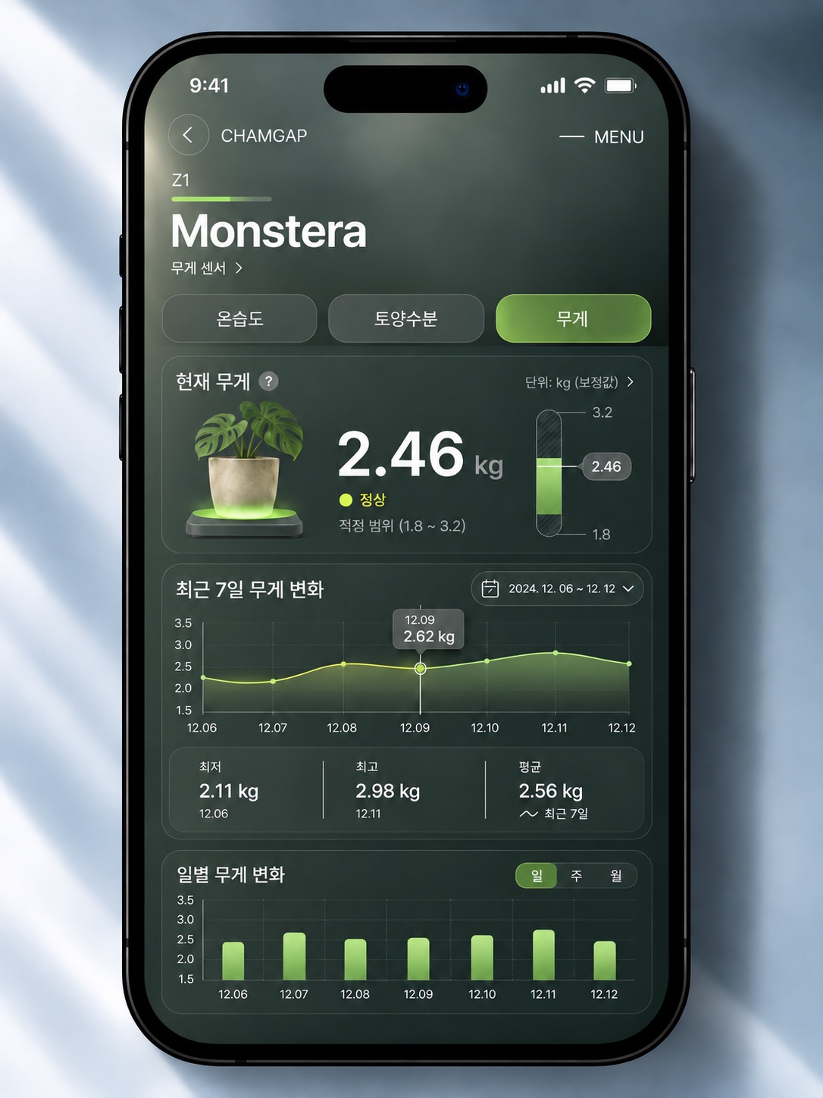
design/KakaoTalk_20261103_165435064_04.jpg
