nanjinhan/chamgap/design/KakaoTalk_20261103_165435064_07.jpg

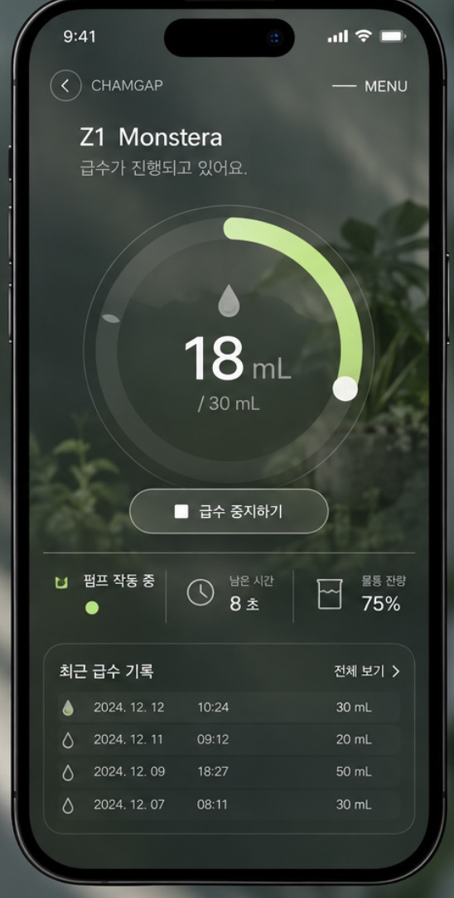
design/KakaoTalk_20261103_165435064_07.jpg
