nanjinhan/chamgap/design/KakaoTalk_20261103_165435064_08.jpg

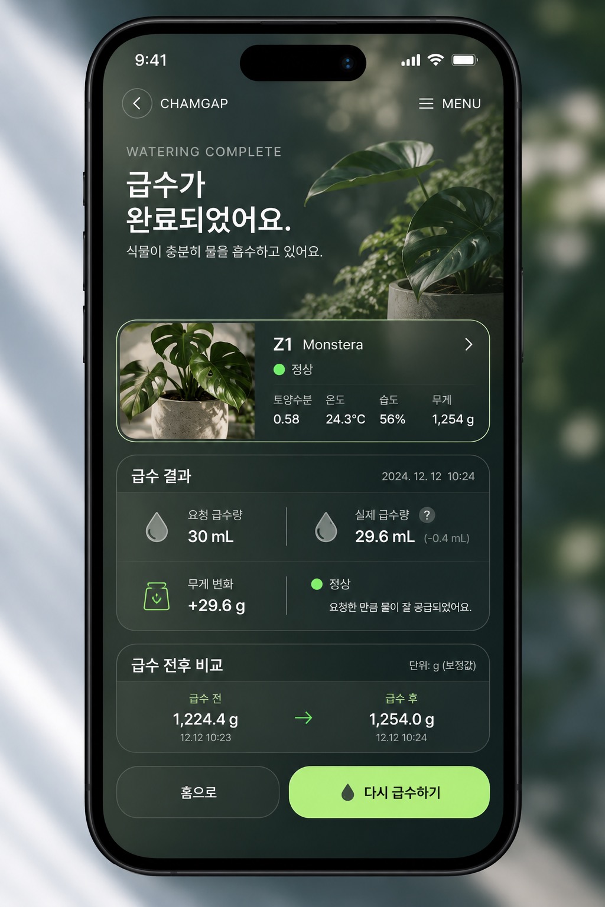
design/KakaoTalk_20261103_165435064_08.jpg
