nanjinhan/chamgap/docs/design/wireframe/png/01.png

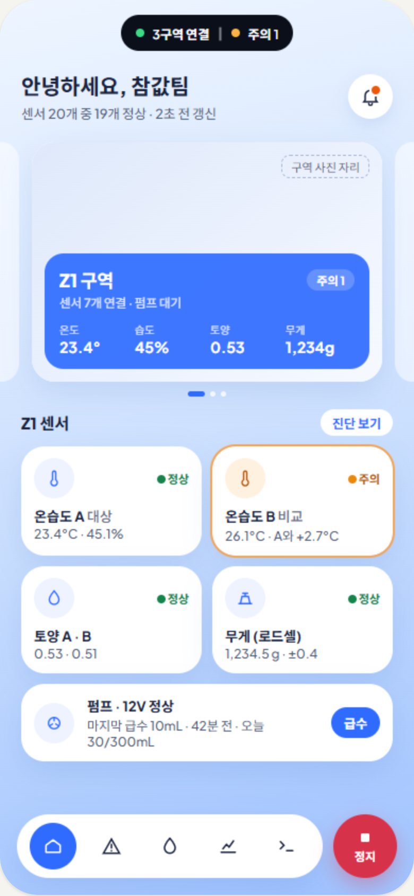
docs/design/wireframe/png/01.png
