nanjinhan/chamgap/docs/design/wireframe/png/02.png

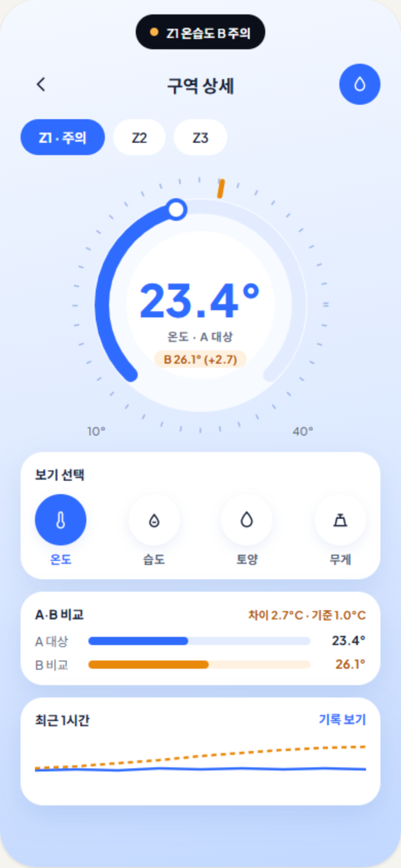
docs/design/wireframe/png/02.png
