nanjinhan/chamgap/docs/design/wireframe/png/03.png

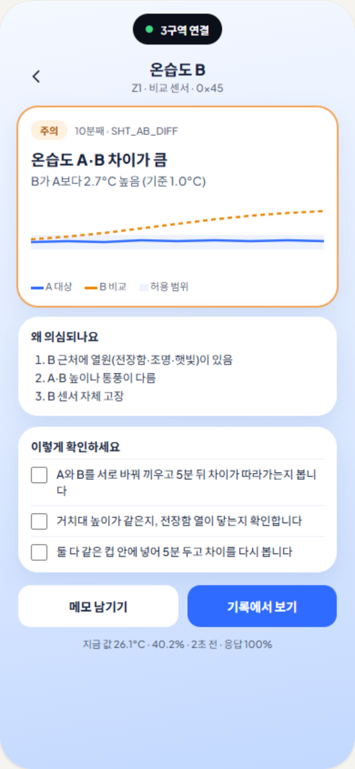
docs/design/wireframe/png/03.png
