nanjinhan/chamgap/docs/design/wireframe/png/04.png

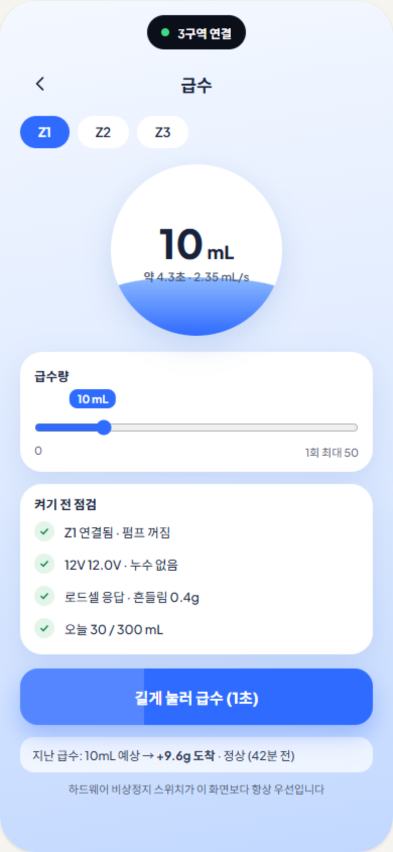
docs/design/wireframe/png/04.png
