nanjinhan/chamgap/docs/design/wireframe/png/05.png

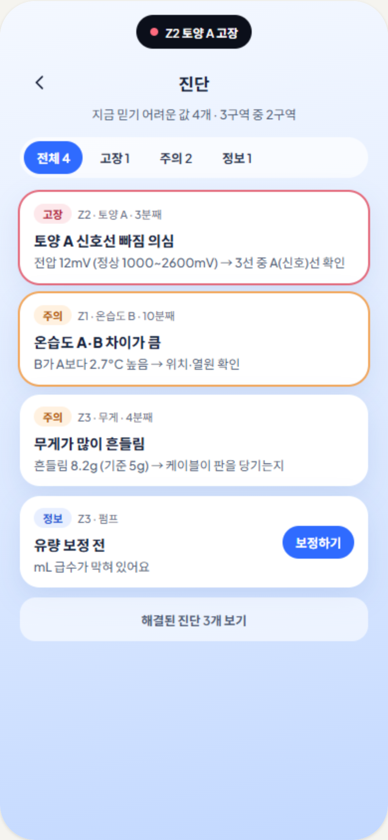
docs/design/wireframe/png/05.png
