nanjinhan/chamgap/docs/design/wireframe/png/06.png

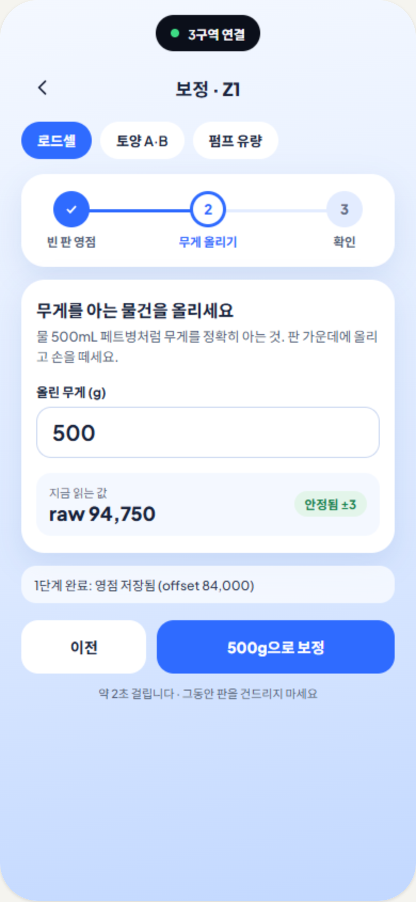
docs/design/wireframe/png/06.png
