nanjinhan/chamgap/docs/design/wireframe/png/07.png

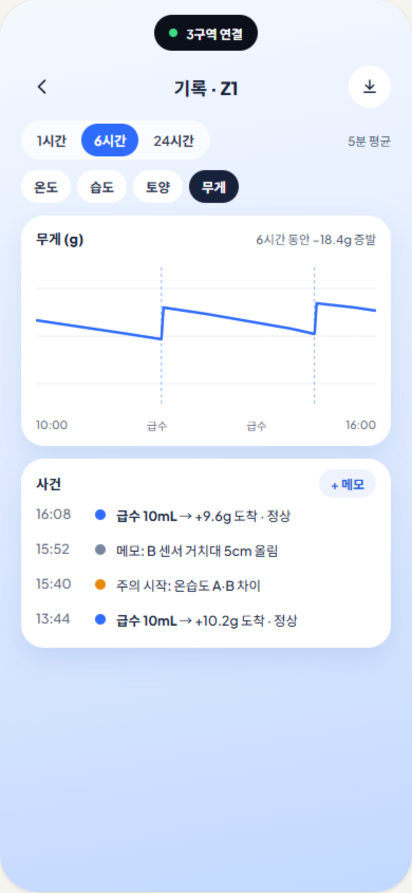
docs/design/wireframe/png/07.png
