nanjinhan/chamgap/docs/design/wireframe/png/10.png

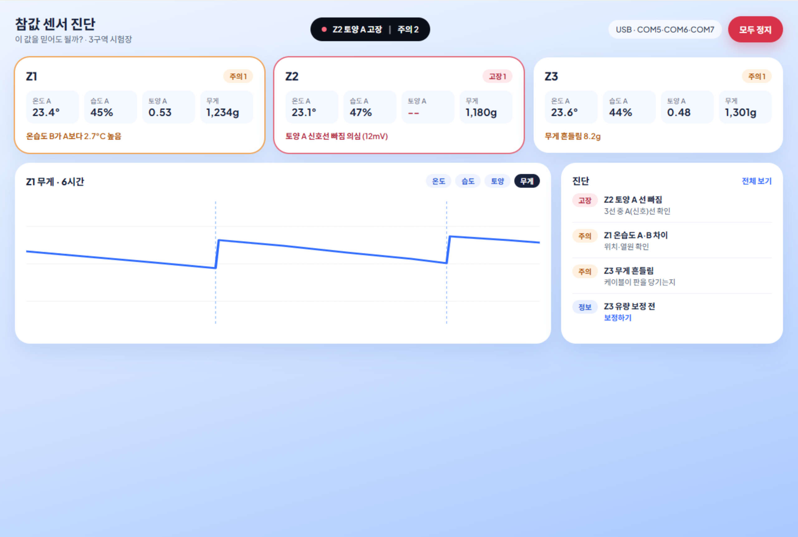
docs/design/wireframe/png/10.png
