nanjinhan/chamgap/server/chamgap/diagnostics/texts.py

"""진단 한국어 문구 (DX-01): 제목 · 왜 의심되는지 · 무엇을 확인할지.

문구는 이 파일 한 곳에만 둔다. 웹앱은 문구를 만들지 않는다.
{sensor}는 센서 이름(예: "온습도 B (비교)"), {pin}은 그 센서의 핀으로 바뀐다.
"""

from __future__ import annotations

from dataclasses import dataclass

SENSOR_NAMES: dict[str, str] = {
    "sht_a": "온습도 A (대상)",
    "sht_b": "온습도 B (비교)",
    "soil_a": "토양 A (대상)",
    "soil_b": "토양 B (비교)",
    "scale": "무게 (로드셀)",
    "pump": "펌프",
    "power": "12V 전원",
    "node": "구역",
}

SENSOR_PINS: dict[str, str] = {
    "sht_a": "I2C SDA 21 · SCL 22 · 주소 0x44",
    "sht_b": "I2C SDA 21 · SCL 22 · 주소 0x45",
    "soil_a": "GPIO32",
    "soil_b": "GPIO33",
    "scale": "HX711 DT 26 · SCK 27",
    "pump": "GPIO25 (DFR0457)",
    "power": "GPIO34 (분압 47k/10k)",
}


@dataclass(frozen=True)
class Text:
    title: str
    causes: tuple[str, ...]
    checks: tuple[str, ...]


T = Text

TEXTS: dict[str, Text] = {
    "NODE_OFFLINE": T(
        "구역 연결 끊김",
        ("USB 케이블이 빠졌거나 노트북이 절전 모드로 들어감", "ESP32 전원이 꺼짐", "WiFi 연결이 끊김 (MQTT 모드)"),
        ("ESP32 보드의 전원 LED가 켜져 있는지 본다",
         "USB 케이블을 다시 꽂고 서버 콘솔에 '연결됨'이 뜨는지 본다",
         "MQTT 모드면 노트북과 ESP32가 같은 WiFi에 있는지 확인한다"),
    ),
    "NODE_REBOOTED": T(
        "ESP32가 재시작됨",
        ("전원이 순간적으로 약해짐 (펌프가 켜질 때 흔함)", "USB 케이블 접촉 불량", "펌웨어 오류로 스스로 재시작"),
        ("펌프를 켤 때마다 재시작되면 펌프 12V와 ESP32 전원이 분리돼 있는지 확인한다",
         "USB 케이블을 짧고 튼튼한 것으로 바꿔 본다",
         "자주 반복되면 시리얼 로그의 재시작 원인 번호를 적어 둔다"),
    ),
    "MSG_GAP": T(
        "측정값이 중간중간 빠짐",
        ("USB 케이블 접촉 불량", "WiFi 신호가 약함", "노트북이 바빠서 처리가 밀림"),
        ("USB 케이블을 살짝 흔들어 보며 끊기는지 본다",
         "MQTT 모드면 WiFi 세기(rssi)가 -75dBm보다 좋은지 본다",
         "공유기와 ESP32 사이 거리를 줄여 본다"),
    ),
    "SHT_NO_RESP": T(
        "{sensor} 응답 없음",
        ("4심 케이블(VIN·GND·SDA·SCL) 중 하나가 빠짐", "주소 설정(ADR)이 잘못됨 — A는 0x44, B는 0x45", "I2C 선이 너무 김"),
        ("센서 쪽과 ESP32 쪽 커넥터를 모두 다시 꽂는다",
         "B 센서는 ADR 핀이 VIN에 연결돼 있는지 본다",
         "시험 스케치 00_i2c로 0x44·0x45가 둘 다 보이는지 확인한다"),
    ),
    "SHT_RANGE": T(
        "{sensor} 값이 범위를 벗어남",
        ("센서가 손상됨", "센서에 물이 묻음", "읽기 오류"),
        ("센서 표면에 물기나 흙이 묻었는지 보고 말린다",
         "손으로 감싸 온도가 천천히 오르는지 본다",
         "계속되면 예비 센서로 바꿔 본다"),
    ),
    "SHT_AB_DIFF": T(
        "온습도 A·B 차이가 큼",
        ("B 센서 근처에 열원(전장함·조명)이 있음", "B 센서 고장", "A·B 높이가 다름"),
        ("A·B를 서로 바꿔 끼워 보고 차이가 센서를 따라가는지 본다 (따라가면 센서 문제, 그대로면 위치 문제)",
         "거치대 높이와 조명·햇빛 위치를 확인한다",
         "전장함·어댑터에서 센서를 떼어 놓는다"),
    ),
    "SHT_STUCK": T(
        "{sensor} 값이 멈춤",
        ("센서 내부가 멈춤", "펌웨어가 같은 값을 계속 보냄", "공기 흐름이 전혀 없음"),
        ("센서에 입김을 불어 습도가 오르는지 본다",
         "구역 화면에서 ESP32를 재시작(reboot)해 본다",
         "계속되면 케이블과 센서를 바꿔 본다"),
    ),
    "SOIL_WIRE": T(
        "{sensor} 배선 이상 의심",
        ("신호선·GND 중 하나가 빠짐", "선끼리 닿음 (단락)"),
        ("센서 쪽 3핀 커넥터를 다시 꽂는다",
         "ESP32 {pin} 쪽 선이 꽂혀 있는지 본다",
         "시험 스케치 02_soil로 mV가 정상 범위로 돌아오는지 본다"),
    ),
    "SOIL_WIRE:low": T(
        "{sensor} 신호선 빠짐 의심",
        ("신호선(AOUT)이 빠짐", "센서 전원(VCC)이 빠짐"),
        ("센서 쪽 3핀 커넥터를 다시 꽂는다",
         "ESP32 {pin} 쪽 선이 꽂혀 있는지 본다",
         "시험 스케치 02_soil로 mV가 1000~2800 사이로 돌아오는지 본다"),
    ),
    "SOIL_WIRE:high": T(
        "{sensor} GND 빠짐·단락 의심",
        ("GND 선이 빠짐", "신호선이 3.3V와 닿음 (단락)"),
        ("센서와 ESP32의 GND 선을 다시 꽂는다",
         "피복이 벗겨져 다른 선과 닿는 곳이 없는지 본다",
         "시험 스케치 02_soil로 mV가 정상 범위로 돌아오는지 본다"),
    ),
    "SOIL_UNCAL": T(
        "{sensor} 보정 전",
        ("토양 보정값(공기·물)이 저장되지 않아 기본값을 쓰는 중",),
        ("보정 마법사에서 '공기 중 → 물컵' 순서로 보정한다",),
    ),
    "SOIL_AB_DIFF": T(
        "토양 A·B 차이가 큼",
        ("두 센서를 꽂은 깊이가 다름", "흙 다짐이 달라 센서와 흙의 접촉이 다름", "물이 한쪽에만 떨어짐"),
        ("두 센서가 경계선까지 같은 깊이로 꽂혔는지 본다",
         "센서 주변 흙을 손가락으로 살짝 눌러 빈틈을 없앤다",
         "출수구가 화분 가운데를 향하는지 본다"),
    ),
    "SOIL_NO_RISE": T(
        "급수했는데 {sensor} 수분이 안 오름",
        ("센서와 흙 사이에 빈틈이 있음", "물이 한쪽으로만 흐름", "센서가 너무 얕게 꽂힘"),
        ("센서를 뽑았다가 경계선까지 다시 꽂고 주변 흙을 눌러 준다",
         "급수할 때 물이 센서 쪽으로도 퍼지는지 직접 본다",
         "출수구 위치를 화분 가운데로 옮긴다"),
    ),
    "SOIL_STUCK": T(
        "{sensor} 값이 오래 그대로",
        ("흙이 아주 마르거나 아주 젖어 변화가 없음", "센서 고장"),
        ("손가락으로 흙 상태를 직접 확인한다",
         "센서를 뽑아 공기 중에서 mV가 오르는지 본다"),
    ),
    "LC_NO_RESP": T(
        "무게 센서(HX711) 응답 없음",
        ("HX711 DT(26)·SCK(27) 선이 빠짐", "HX711 3.3V 전원이 빠짐", "HX711 보드 고장"),
        ("HX711 보드의 DT·SCK·VCC·GND 선을 다시 꽂는다",
         "시험 스케치 03_loadcell로 raw 값이 나오는지 본다",
         "로드셀 4선(빨강·검정·흰·초록) 연결을 확인한다"),
    ),
    "LC_UNCAL": T(
        "무게 센서 보정 전",
        ("영점(tare)이나 배율(cal) 값이 저장되지 않음",),
        ("보정 마법사에서 '빈 판 영점 → 아는 무게' 순서로 보정한다",),
    ),
    "LC_NOISY": T(
        "무게 값이 흔들림",
        ("케이블이 계량판을 당김", "판이 화분 받침·벽에 닿음", "바람·진동"),
        ("로드셀 케이블이 판에 걸리지 않게 늘어뜨린다",
         "판 둘레에 손가락이 들어갈 틈이 있는지 본다",
         "선풍기·환풍기를 잠시 끄고 흔들림이 줄어드는지 본다"),
    ),
    "LC_NEGATIVE": T(
        "무게가 0보다 많이 작음",
        ("화분을 올린 채 영점을 잡음", "판이 아래에서 무언가에 받쳐짐"),
        ("화분을 내리고 빈 판에서 영점(tare)을 다시 잡는다",
         "판 아래에 걸리는 것이 없는지 본다"),
    ),
    "LC_OVERLOAD": T(
        "무게 정격 초과",
        ("7kg이 넘는 무게가 올라감 (10kg 센서, 7kg 이하 운용)", "판을 손으로 누름"),
        ("화분 전체 무게를 7kg 이하로 줄인다",
         "판 위에 다른 물건이 없는지 본다"),
    ),
    "LC_DRIFT_UP": T(
        "급수 없이 무게가 늘어남",
        ("잎·지지대·케이블이 판에 기댐", "온도 변화에 따른 로드셀 드리프트"),
        ("판과 화분에 기댄 것이 없는지 본다",
         "손으로 물을 줬다면 메모를 남겨 기록에 표시한다",
         "빈 판에서 영점이 0 근처인지 다시 확인한다"),
    ),
    "WATER_NOT_ARRIVED": T(
        "물이 화분에 도착하지 않음",
        ("튜브가 막히거나 꺾임", "펌프 헤드 문제", "출수구가 화분 밖을 향함"),
        ("튜브를 따라가며 꺾이거나 눌린 곳을 편다",
         "출수구가 화분 안에 있는지 본다",
         "컵에 대고 짧게 돌려 물이 나오는지 본다 (유량 보정 화면)"),
    ),
    "WATER_OVER": T(
        "예상보다 물이 많이 들어감",
        ("유량 보정값이 실제보다 작음", "펌프가 꺼진 뒤에도 물이 흐름 (사이펀)"),
        ("유량 보정을 다시 한다",
         "물통 수면이 출수구보다 높지 않은지 본다 (사이펀)",
         "펌프가 꺼진 뒤 출수구에서 물이 계속 떨어지는지 본다"),
    ),
    "PUMP_REFUSED": T(
        "펌프 요청이 거부됨",
        ("ESP32가 안전 규칙에 따라 거부함",),
        ("거부 이유를 확인하고 다시 시도한다",),
    ),
    "PUMP_REFUSED:cooldown": T(
        "펌프 요청이 거부됨 (쉬는 시간)",
        ("펌프가 꺼진 지 3초가 지나지 않음",),
        ("3초 뒤에 다시 시도한다",),
    ),
    "PUMP_REFUSED:already_on": T(
        "펌프 요청이 거부됨 (이미 켜짐)",
        ("이미 급수 중이라 겹쳐 켤 수 없음",),
        ("지금 급수가 끝날 때까지 기다린다", "멈추려면 정지 버튼을 누른다"),
    ),
    "PUMP_REFUSED:bad_ms": T(
        "펌프 요청이 거부됨 (시간 범위)",
        ("한 번에 켤 수 있는 시간(0.05~15초)을 벗어남",),
        ("급수량을 줄인다", "유량 보정값이 너무 작게 저장되지 않았는지 본다"),
    ),
    "PUMP_REFUSED:no_12v": T(
        "펌프 요청이 거부됨 (12V 없음)",
        ("비상정지 버튼이 눌림", "분기 퓨즈가 끊어짐", "12V 어댑터가 빠짐"),
        ("비상정지 버튼을 돌려 풀었는지 본다", "이 구역의 분기 퓨즈를 확인한다"),
    ),
    "PUMP_REFUSED:leak": T(
        "펌프 요청이 거부됨 (누수)",
        ("누수 센서가 물을 감지함",),
        ("받침 위 물기를 닦고 누수 센서를 말린다", "튜브 연결부를 확인한다"),
    ),
    "FLOW_UNCAL": T(
        "펌프 유량 보정 전",
        ("유량(mL/s) 값이 저장되지 않아 mL로 급수할 수 없음",),
        ("보정 마법사에서 10초 동안 펌프를 돌려 유량을 잰다",),
    ),
    "V12_MISSING": T(
        "12V 전원 없음",
        ("비상정지 버튼이 눌림", "분기 퓨즈가 끊어짐", "12V 어댑터가 빠짐"),
        ("비상정지 버튼을 돌려 풀었는지 본다",
         "이 구역의 분기 퓨즈를 확인한다",
         "12V 어댑터 LED와 플러그를 확인한다"),
    ),
    "LEAK": T(
        "누수 감지",
        ("튜브 연결부에서 물이 샘", "화분 받침이 넘침"),
        ("받침 위 물기를 닦고 누수 센서를 말린다",
         "튜브 연결부를 조이고 짧게 다시 시험한다",
         "물기가 없는데 계속되면 누수 센서 배선(GPIO35)을 확인한다"),
    ),
}


def text_for(code: str, sensor: str, variant: str | None = None) -> Text:
    base = TEXTS.get(f"{code}:{variant}") if variant else None
    t = base or TEXTS[code]
    fmt = {"sensor": SENSOR_NAMES.get(sensor, sensor), "pin": SENSOR_PINS.get(sensor, "")}
    return Text(
        t.title.format(**fmt),
        tuple(c.format(**fmt) for c in t.causes),
        tuple(c.format(**fmt) for c in t.checks),
    )


def fmt_dur(seconds: float) -> str:
    """경과 시간 한국어: 45초, 3분, 1시간 20분"""
    s = max(0, int(seconds))
    if s < 60:
        return f"{s}초"
    m = s // 60
    if m < 60:
        return f"{m}분"
    h, m = divmod(m, 60)
    return f"{h}시간" + (f" {m}분" if m else "")
