nanjinhan/chamgap/(commit log)

2026-10-23 참값 센서 진단 시스템: 서버, 웹앱 뼈대·홈 화면, USB 펌웨어, 문서
    - server/: Python 브리지 서버 (USB·MQTT·mock 연결, 진단 규칙 24개, 안전 검사, SQLite, WebSocket), 테스트 221개
    - web/: React 웹앱 (와이어프레임 기준 공통 틀과 홈 화면, 실시간 연결)
    - firmware/node/: ESP32 노드 펌웨어 USB 시리얼 버전 (DHT11·토양 2·로드셀)
    - docs/: 요구사항지시서 v2.0 (Supabase·Vercel 구조), 인계서, 와이어프레임
2026-10-23 Supabase 준비(P1) 파일과 인계서 갱신
    - supabase/schema.sql: 표(readings·events·nodes·commands·diagnostics), 권한(RLS·기기 키), 실시간, 자동 정리, 그래프 함수
    - supabase/README.md: 프로젝트 만들기부터 키 확인까지 클릭 안내
    - firmware/node/secrets.example.h: ESP32 비밀값 예시 (실제 secrets.h는 올리지 않음)
    - docs/04_이어서_만들기.md: 위치 이동(C:\dev\chamgap), Supabase 진행 상황
2026-10-23 Supabase 권한 확인 스크립트 추가, P1 완료
    - supabase/check.mjs: 공개 키로 읽기·쓰기 거부·명령 허용 목록·트리거·만료(expired) 23개 확인
    - web/.env.example: VITE_SUPABASE_URL, VITE_SUPABASE_ANON_KEY 틀
    - 인계서·supabase/README 갱신 (진짜 공개 키로 23개 모두 통과)
2026-10-24 P2: ESP32 펌웨어 WiFi·Supabase 버전 (사용자 실물 확인 대기)
    - firmware/node/cloud.h: WiFi·HTTPS·Realtime(WebSocket)을 코어 0 작업으로, 본 루프는 큐에 넣기만
    - node.ino: readings·events·nodes 올리기, 웹 명령 실행·결과 적기, flowcal, 오늘 급수량 NVS+NTP
    - config.h: USE_CLOUD, flowcal 설정, SHT31 A·B 사용(DHT11 끔)
    - schema.sql: claim_command·finish_command, nodes 시각 트리거, sent 3분 무응답 failed
    - check.mjs: 기기 키 확인(행 안 남김), 명령 가져가기·결과 적기 시험
    - README·인계서 갱신
    [cloud.h, config.h, node.ino]
2026-11-03 P2 완료: 실물 Z1(토양 A만)이 Supabase에 값 올리기·명령 실행 확인
    - cloud.h: WiFi 최대 3곳(학교·집 등) 중 보이는 가장 센 곳에 연결, 못 찾으면 보이는 WiFi 이름 출력
    - config.h: 쇼트로 다른 센서를 빼고 토양 A(32번)만 켬
    - secrets.example.h: WIFI_SSID2/3 칸
    - docs/05_앱_디자인_브리프.md: 앱·웹 재디자인용 설명서
    - README·인계서 갱신 (readings 5초마다, info 명령 1.55초에 done)
2026-11-03 P4: 웹 데이터 계층을 Supabase로 교체 (실물 Z1로 확인)
    - lib/supabase.ts·live.ts·nodeState.ts·commands.ts 추가, 예전 서버용 ws.ts·api.ts·Vite 프록시 삭제
    - Realtime으로 readings·events·commands·diagnostics, 재연결 때 다시 불러오기, 15초마다 놓친 값 확인
    - 끊김·n초 전은 Supabase 시각 기준, 센서 상태는 데이터가 말하는 것(읽기 실패·보정 전)만
    - 정지 버튼이 commands에 stop을 넣고 결과 확인, 단 센서만 세고 안 단 것은 미설치
    - web/README, 인계서 갱신
2026-11-03 P7 준비: Vercel SPA 설정(web/vercel.json), 인계서 갱신
2026-11-03 P7 배포 완료(https://chamgap.vercel.app), 보드 WiFi 불안정 기록
2026-11-03 펌웨어: WiFi 절전 끔, TLS 대기 10초, Realtime 별도 작업, 스스로 다시 연결·재시작, 원격 진단 숫자
2026-11-03 펌웨어: WiFi 훑기 실패 때도 바로 연결 시도, 장치 재시작, 10분 못 붙으면 재시작
2026-11-03 새 디자인 D1: 공통 틀(CHAMGAP·정지·MENU)과 홈 화면, Pretendard, 디자인 원본 이미지
2026-11-03 새 디자인 전체: 구역 상세·센서 상세 3탭·급수 4화면, 넓은 화면 2단, 공통 부품·그래프, 인계서 정리
2026-11-03 남은 화면: 보정 마법사·기록·진단·설정을 새 디자인으로, 홈 A·B 평균, 시험 모드 삭제
2026-11-03 인계서: 새 디자인 배포 반영 기록
2026-11-03 홈: 제목·상세 보기·사진 위 측정값을 눌러 구역·센서 상세로 가게
2026-11-03 급수 상태·결과를 언제든: /water/:node/now·result, 홈 폰 화면 가로 넘침 고침
    - 급수 상태(08): 평소엔 대기 중, 펌프가 돌면 같은 화면에서 진행, 멈추면 결과로
    - 급수 결과(09): Supabase에서 마지막 급수(pump_on/pump_off)와 앞뒤 무게를 찾아 표시, 없으면 빈 화면 안내
    - 급수 제어: 시작하면 상태 화면으로, 상태·지난 결과 링크, 급수 중 알림
    - 홈: '급수 상태 ›', 펌프가 돌면 '급수 중' 버튼, 오른쪽 숫자 칸이 폰 화면 밖으로 넘치던 것 고침
